knockimov/knocker_brewery_ispindle/pics/assembled.jpg

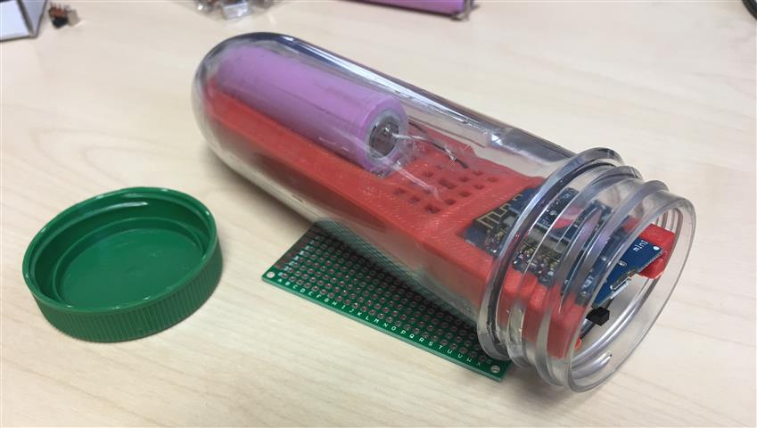
pics/assembled.jpg
