knockimov/knocker_brewery_ispindle/pics/assembled2.jpg

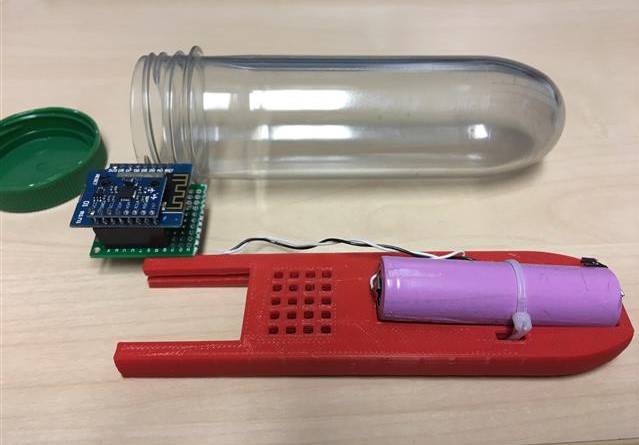
pics/assembled2.jpg
