knockimov/knocker_brewery_ispindle/drawer/mwx-Edition/mwx-Edition.jpg

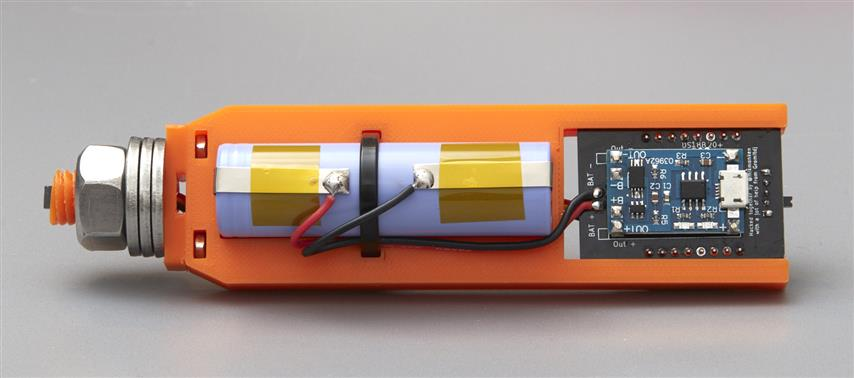
drawer/mwx-Edition/mwx-Edition.jpg
