knockimov/knocker_brewery_ispindle/images/esp8266_E12_pinouts.png

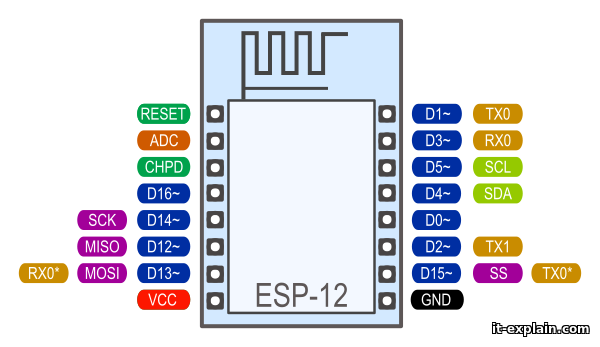
images/esp8266_E12_pinouts.png
