knockimov/knocker_brewery_ispindle/images/ispindel-v150-ESP12F--SMD1206_pcb.png

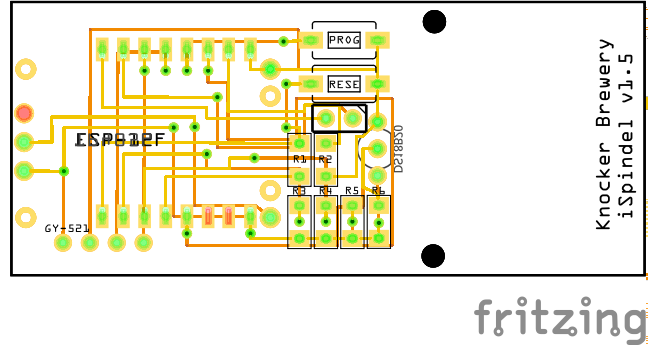
images/ispindel-v150-ESP12F--SMD1206_pcb.png
