knockimov/knocker_brewery_ispindle/images/ispindel-v150-WemosD1--SMD1206_pcb.png

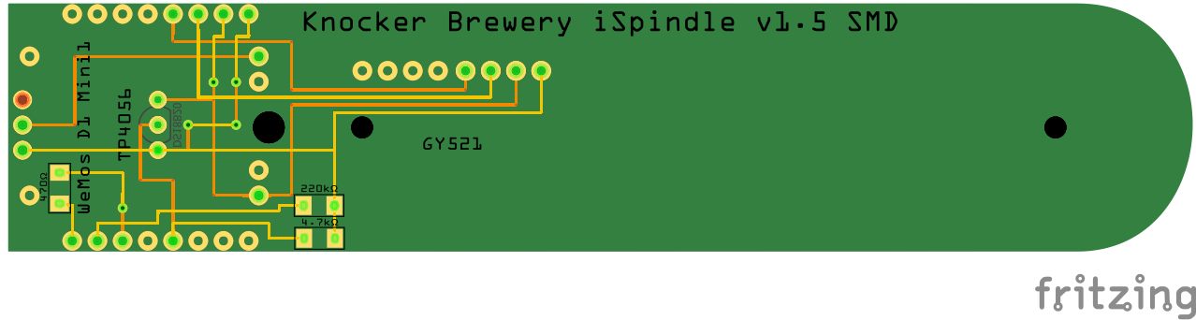
images/ispindel-v150-WemosD1--SMD1206_pcb.png
