knockimov/knocker_brewery_ispindle/pics/AP.png

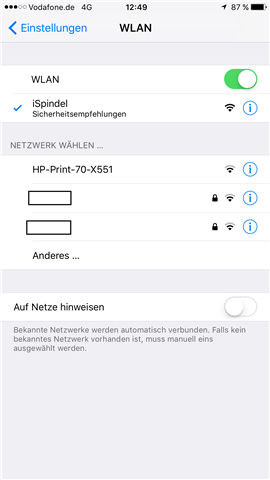
pics/AP.png
