knockimov/knocker_brewery_ispindle/pics/BB/1.jpg

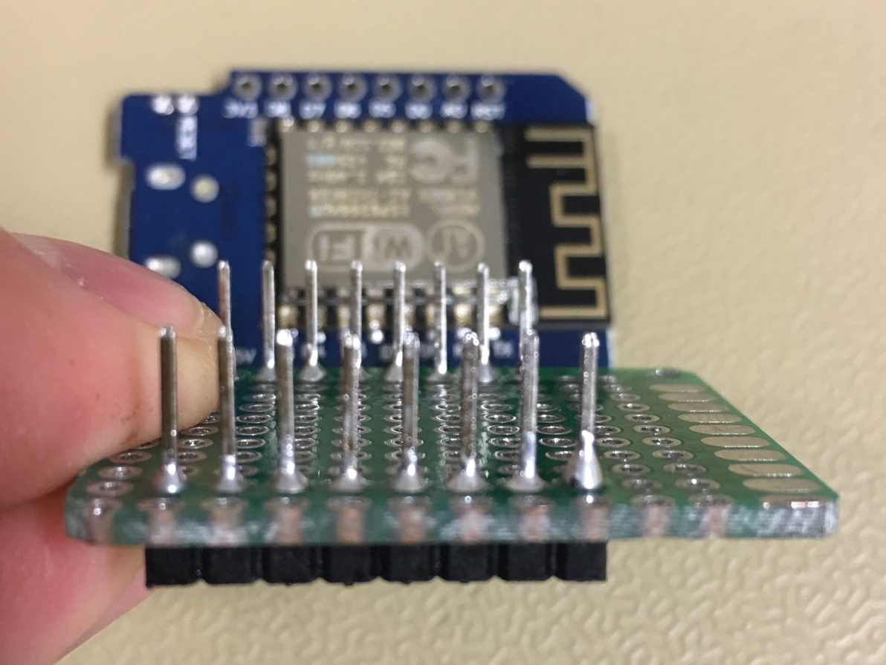
pics/BB/1.jpg
