knockimov/knocker_brewery_ispindle/pics/BB/2.jpg

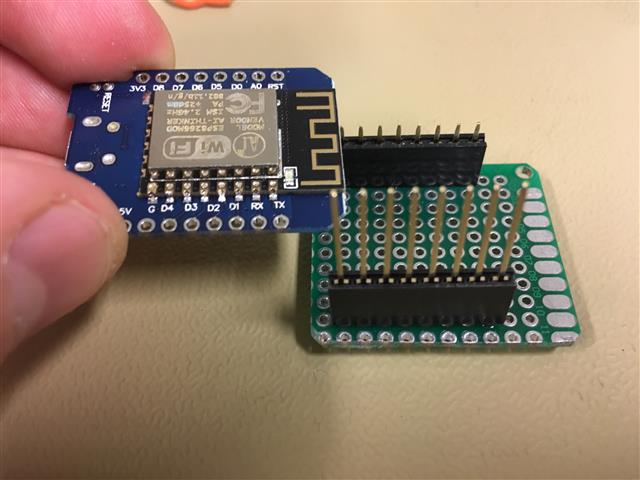
pics/BB/2.jpg
