knockimov/knocker_brewery_ispindle/pics/BB/3.jpg

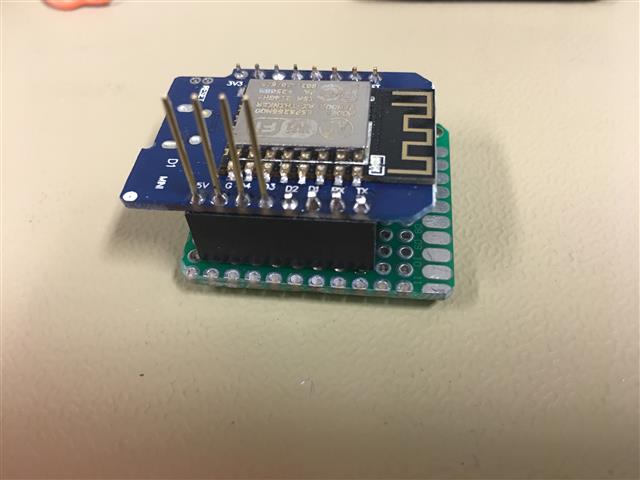
pics/BB/3.jpg
