knockimov/knocker_brewery_ispindle/pics/BB/4.jpg

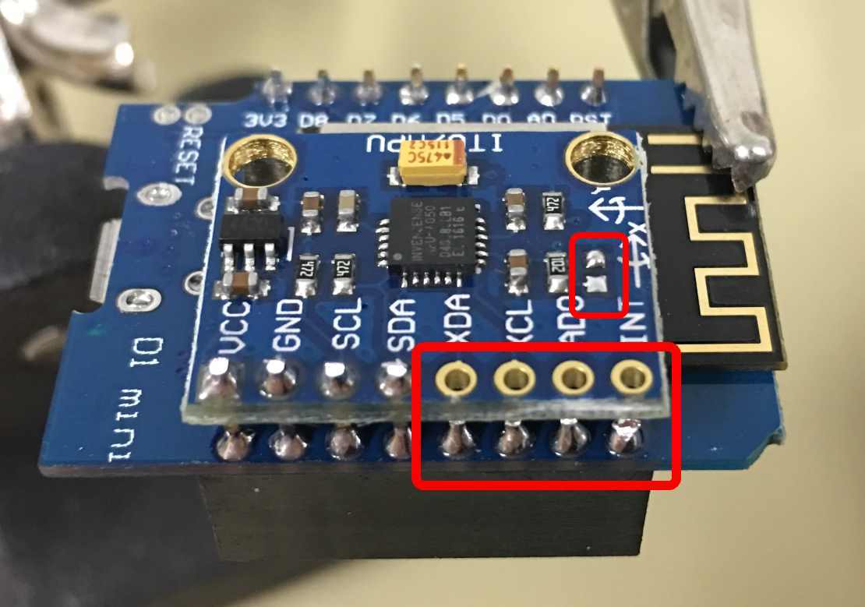
pics/BB/4.jpg
