knockimov/knocker_brewery_ispindle/pics/BB/5.jpg

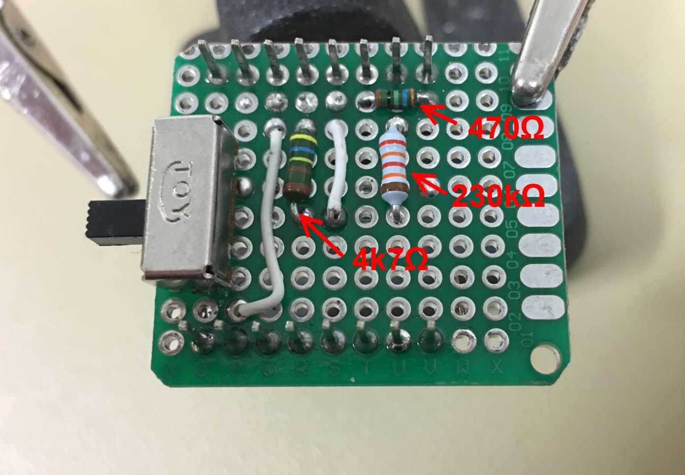
pics/BB/5.jpg
