knockimov/knocker_brewery_ispindle/pics/BB/6.jpg

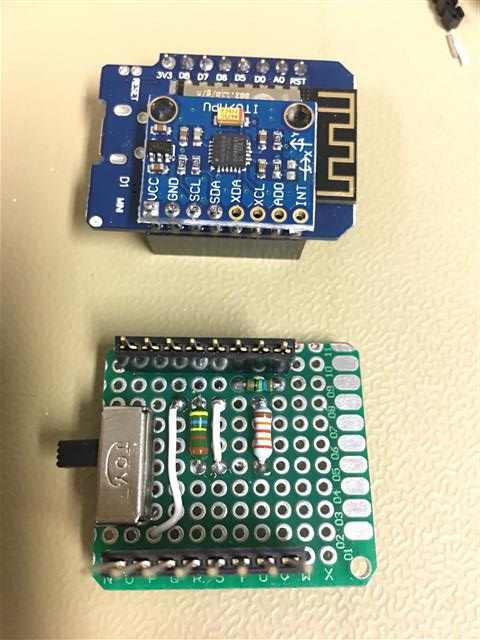
pics/BB/6.jpg
