knockimov/knocker_brewery_ispindle/pics/BB/7.jpg

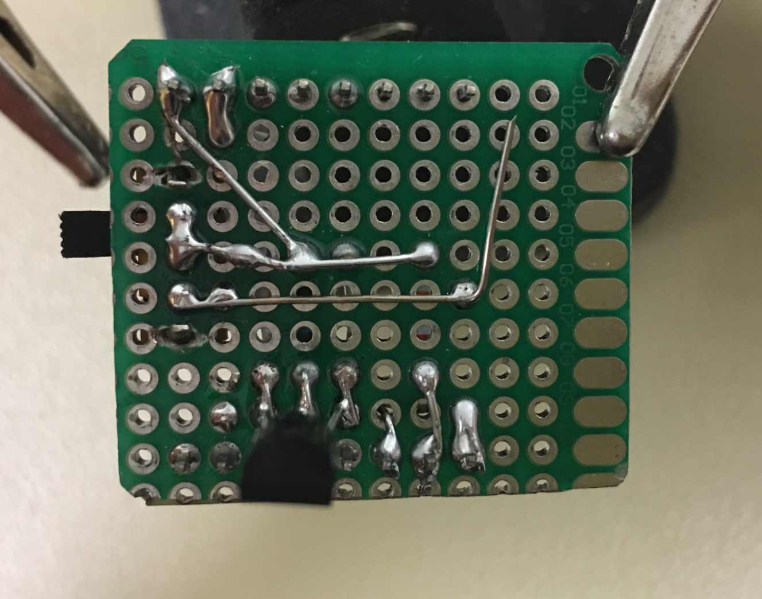
pics/BB/7.jpg
