knockimov/knocker_brewery_ispindle/pics/BB/8.jpg

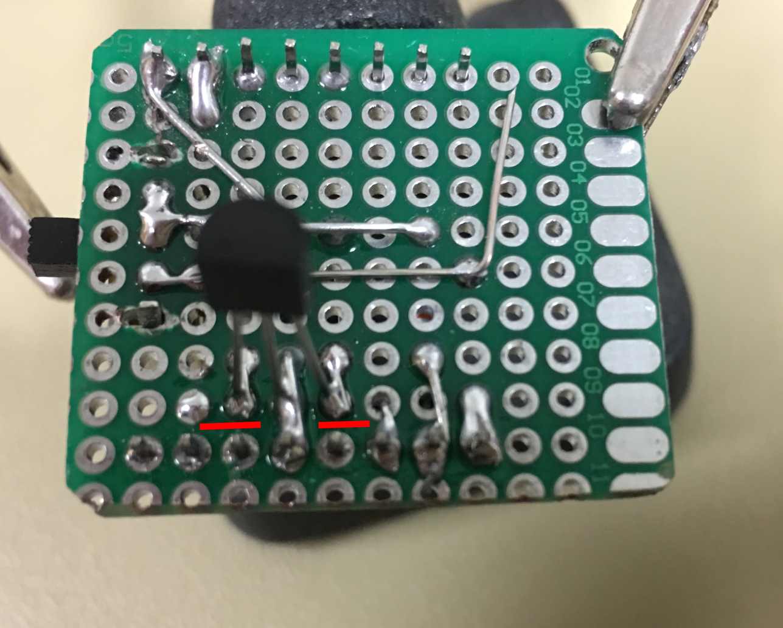
pics/BB/8.jpg
