knockimov/knocker_brewery_ispindle/pics/BB/9.jpg

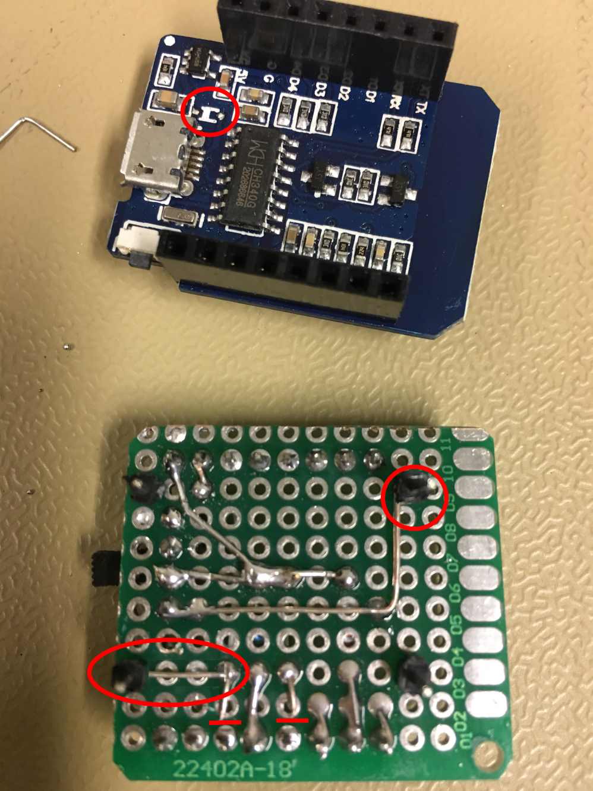
pics/BB/9.jpg
