knockimov/knocker_brewery_ispindle/pics/BB/10.jpg

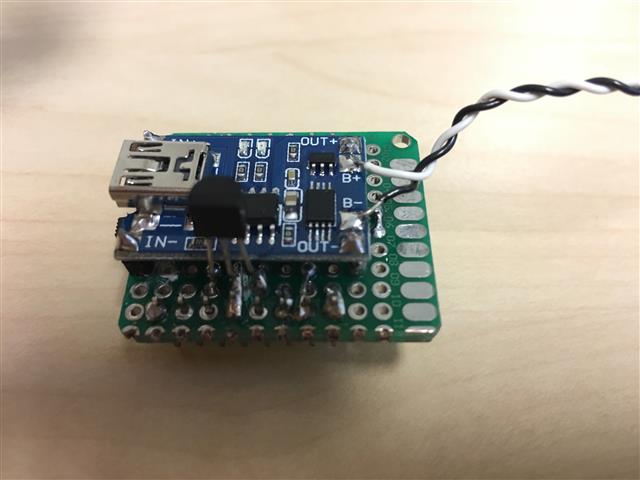
pics/BB/10.jpg
