knockimov/knocker_brewery_ispindle/pics/BB/11.jpg

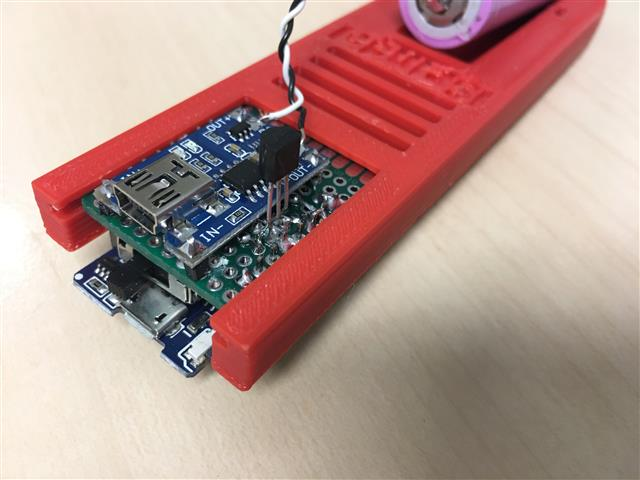
pics/BB/11.jpg
