knockimov/knocker_brewery_ispindle/pics/blackedition.png

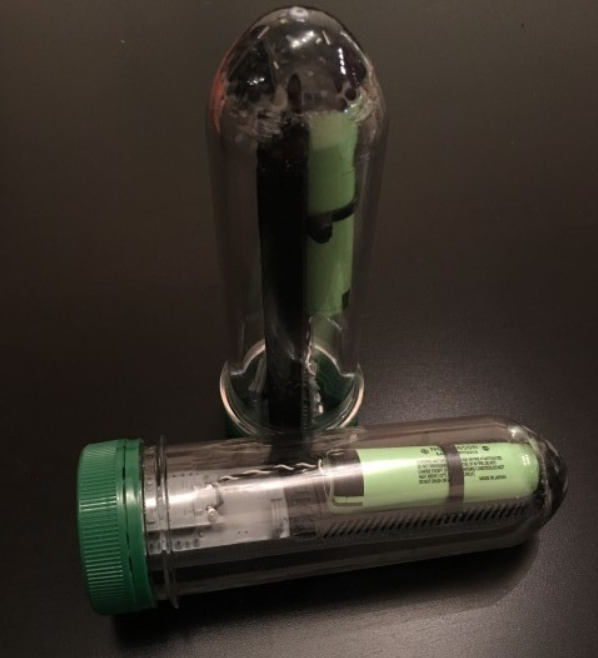
pics/blackedition.png
