knockimov/knocker_brewery_ispindle/pics/Braumagazin.png

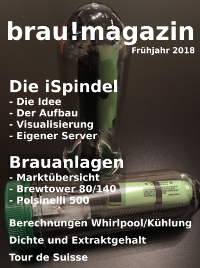
pics/Braumagazin.png
