knockimov/knocker_brewery_ispindle/pics/configuration.png

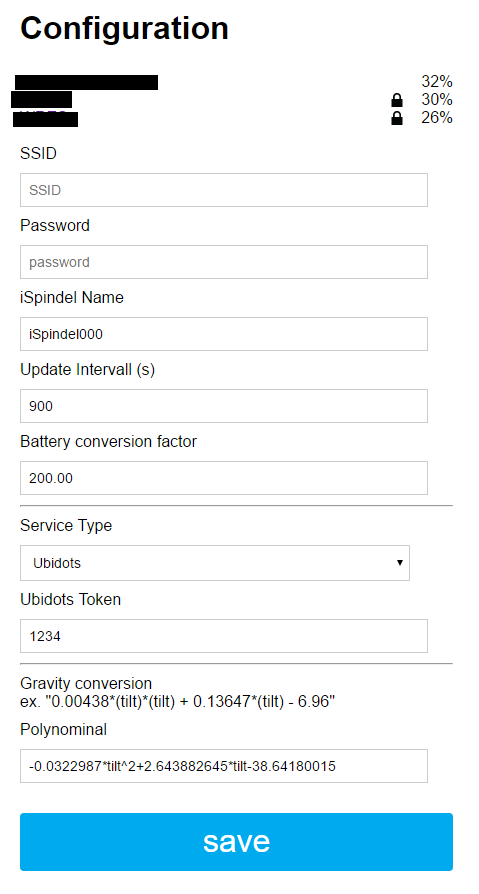
pics/configuration.png
