knockimov/knocker_brewery_ispindle/pics/Dashboard.jpg

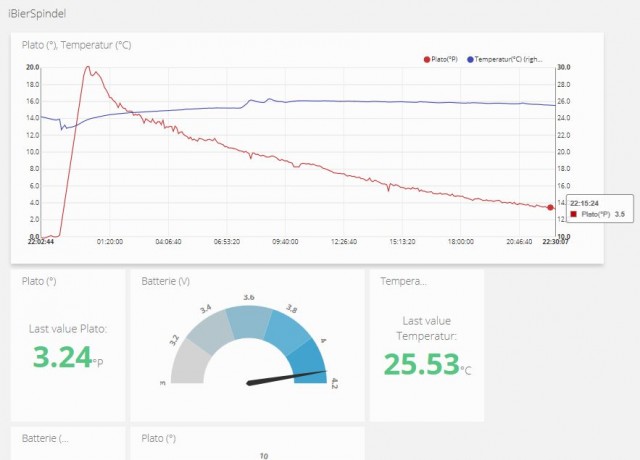
pics/Dashboard.jpg
