knockimov/knocker_brewery_ispindle/pics/Excelcalc.jpg

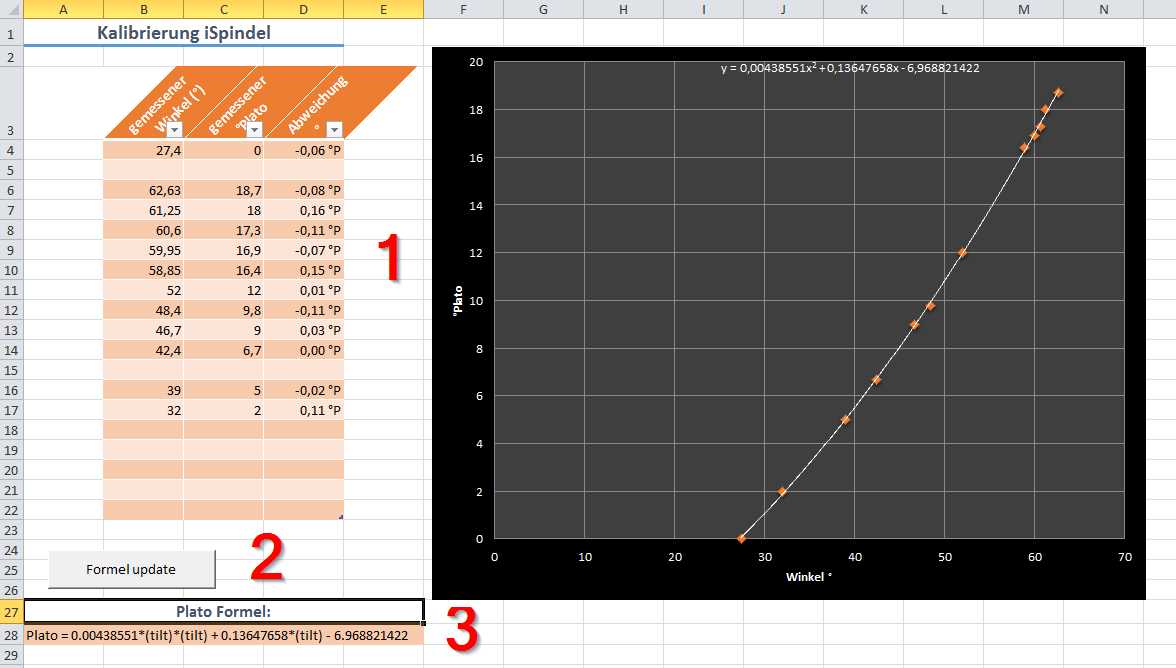
pics/Excelcalc.jpg
