knockimov/knocker_brewery_ispindle/pics/FHEM-iSpindel-gplot.png

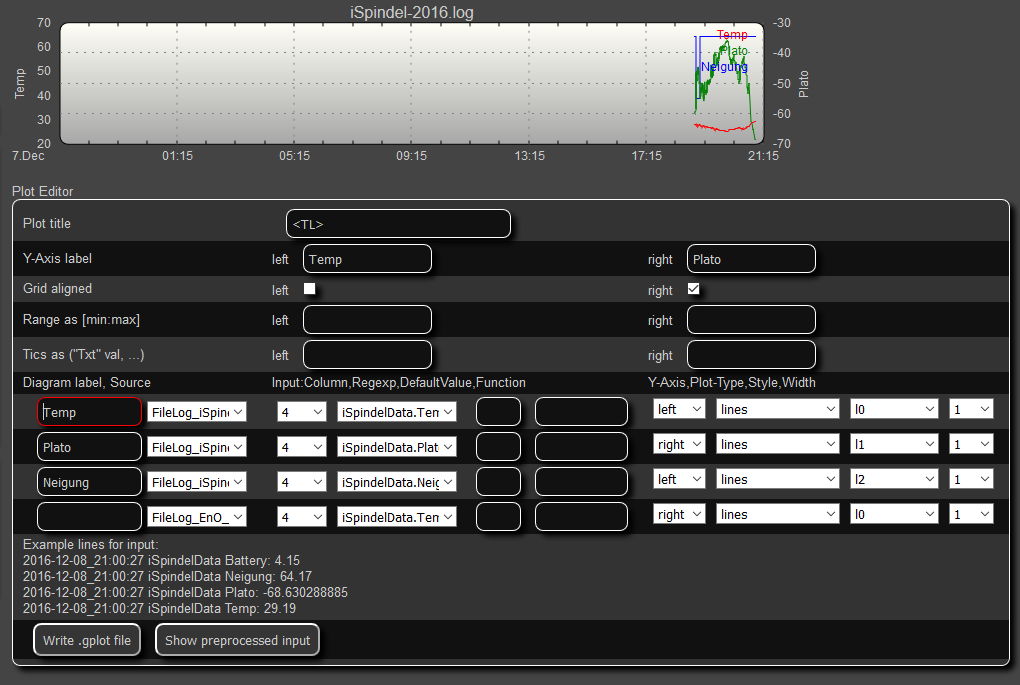
pics/FHEM-iSpindel-gplot.png
