knockimov/knocker_brewery_ispindle/pics/floating.jpg

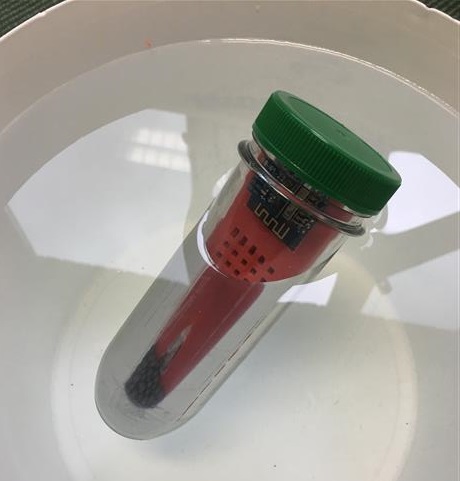
pics/floating.jpg
