knockimov/knocker_brewery_ispindle/pics/info.png

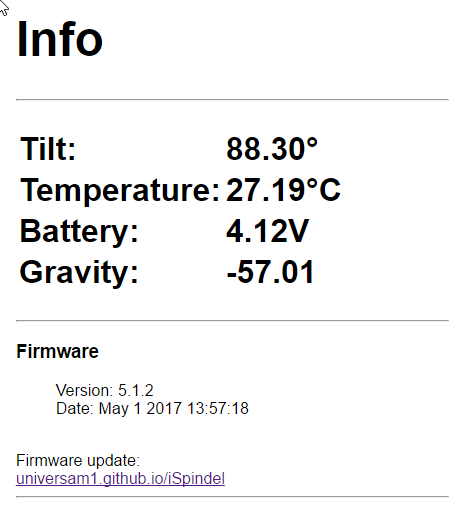
pics/info.png
