knockimov/knocker_brewery_ispindle/pics/kraengung.jpg

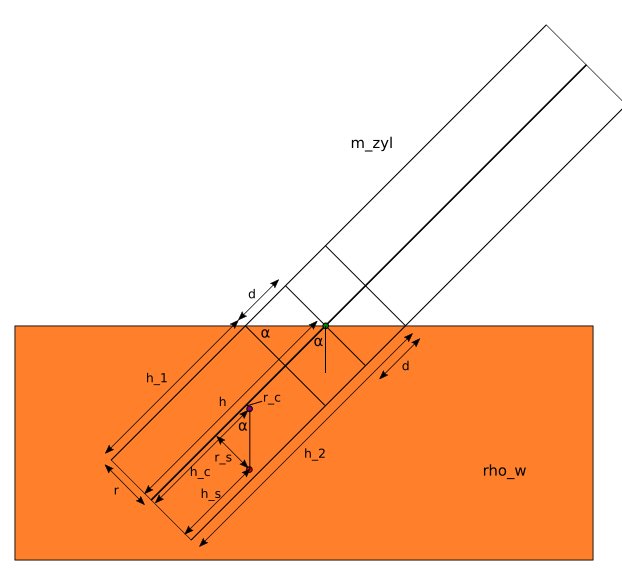
pics/kraengung.jpg
