knockimov/knocker_brewery_ispindle/pics/PCB+Tray/Diode.png

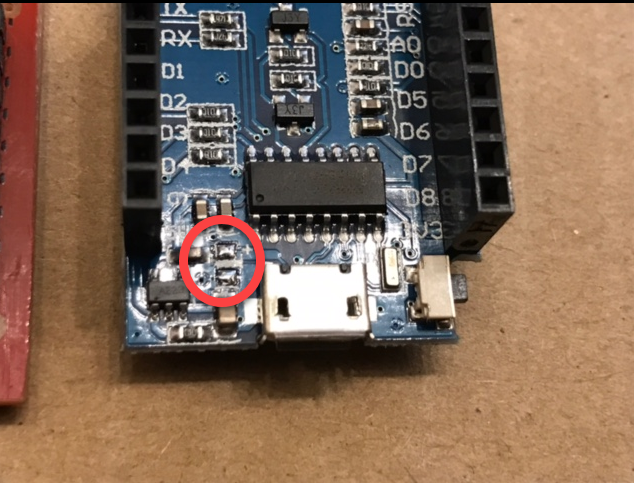
pics/PCB+Tray/Diode.png
