knockimov/knocker_brewery_ispindle/pics/PCB+Tray/IMG_9255.JPG

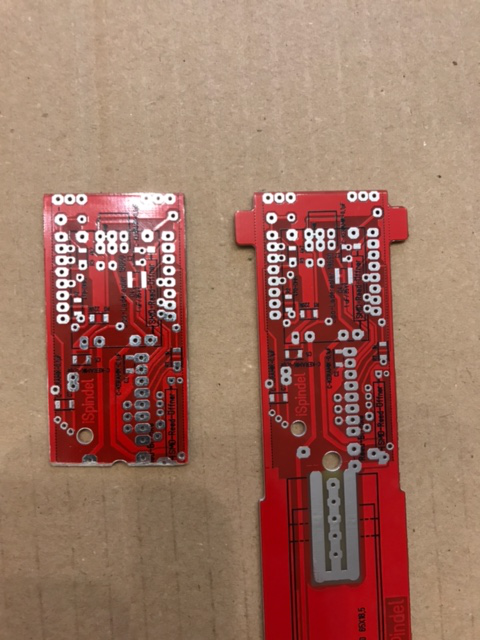
pics/PCB+Tray/IMG_9255.JPG
