knockimov/knocker_brewery_ispindle/pics/PCB+Tray/IMG_9256.JPG

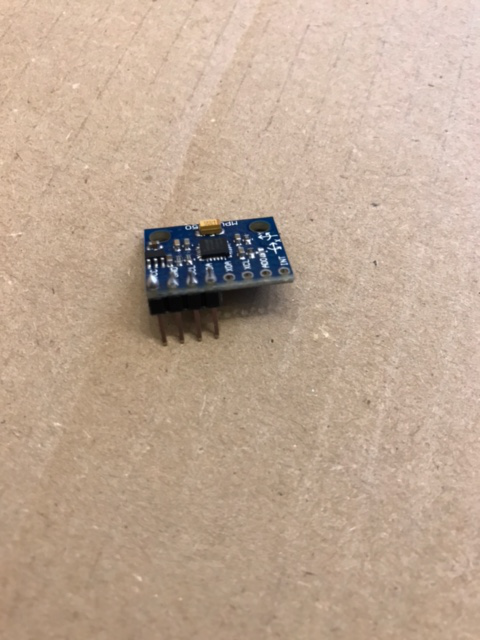
pics/PCB+Tray/IMG_9256.JPG
