knockimov/knocker_brewery_ispindle/pics/PCB+Tray/IMG_9259.JPG

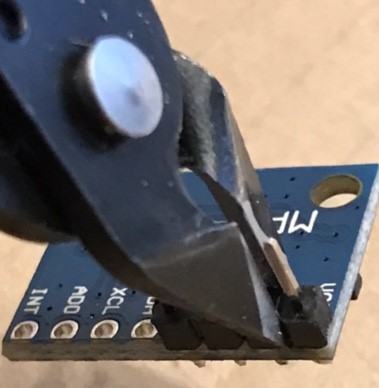
pics/PCB+Tray/IMG_9259.JPG
