knockimov/knocker_brewery_ispindle/pics/PCB+Tray/IMG_9260.JPG

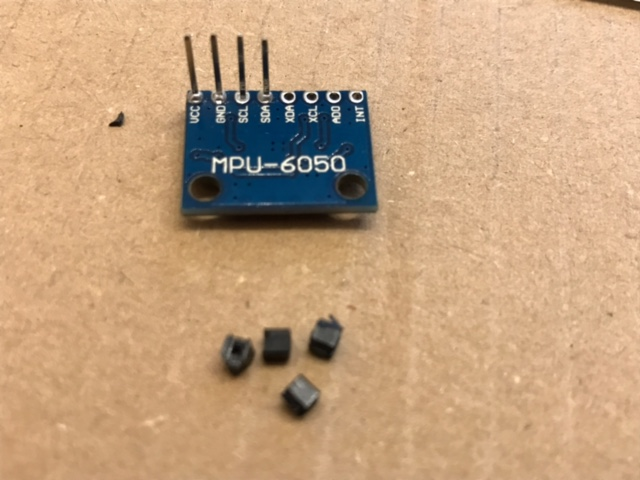
pics/PCB+Tray/IMG_9260.JPG
