knockimov/knocker_brewery_ispindle/pics/PCB+Tray/IMG_9262.JPG

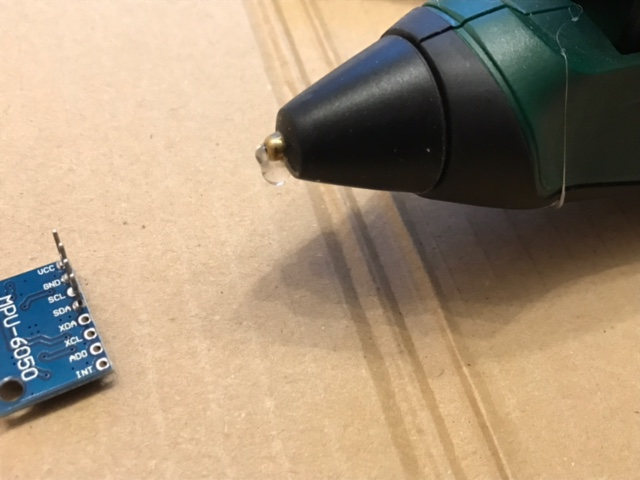
pics/PCB+Tray/IMG_9262.JPG
