knockimov/knocker_brewery_ispindle/pics/PCB+Tray/IMG_9263.JPG

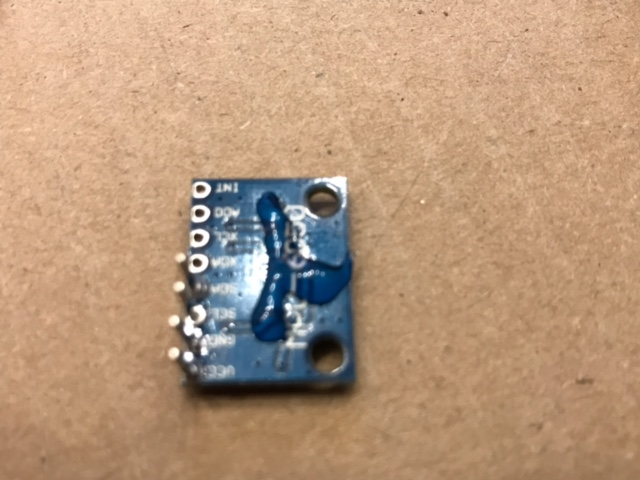
pics/PCB+Tray/IMG_9263.JPG
