knockimov/knocker_brewery_ispindle/pics/PCB+Tray/IMG_9264.JPG

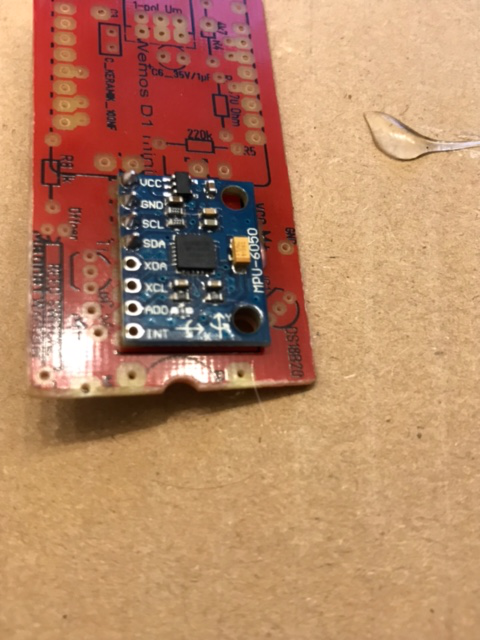
pics/PCB+Tray/IMG_9264.JPG
