knockimov/knocker_brewery_ispindle/pics/PCB+Tray/IMG_9265.JPG

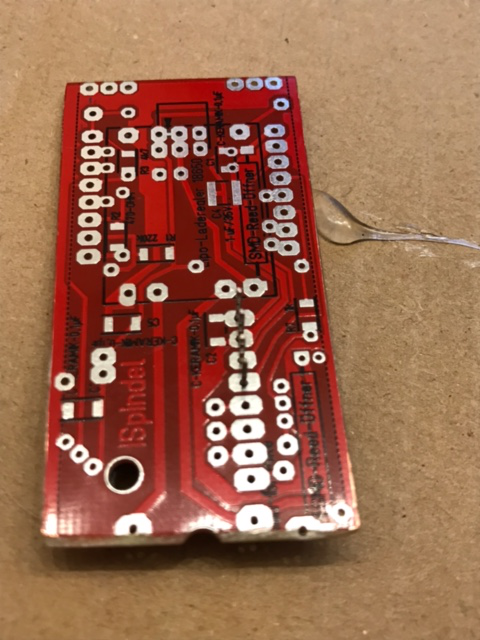
pics/PCB+Tray/IMG_9265.JPG
