knockimov/knocker_brewery_ispindle/pics/PCB+Tray/IMG_9266.JPG

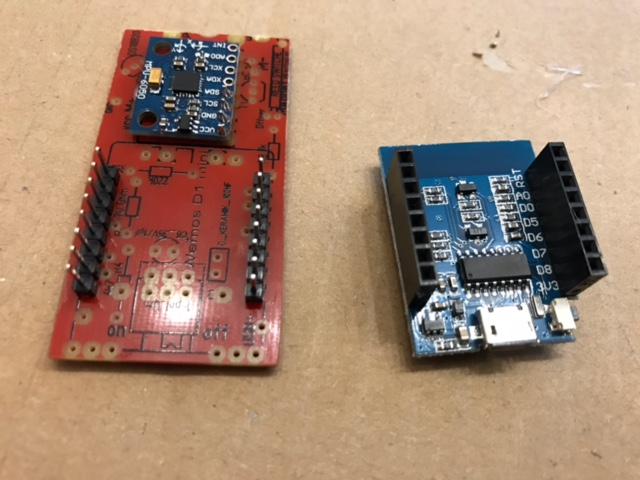
pics/PCB+Tray/IMG_9266.JPG
