knockimov/knocker_brewery_ispindle/pics/PCB+Tray/IMG_9272.JPG

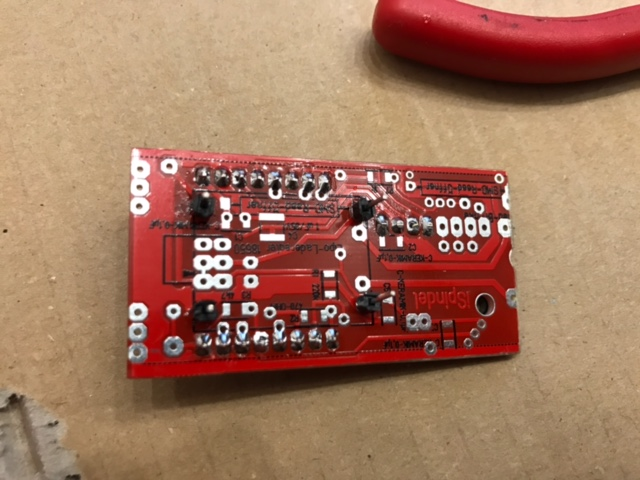
pics/PCB+Tray/IMG_9272.JPG
