knockimov/knocker_brewery_ispindle/pics/PCB+Tray/IMG_9273.JPG

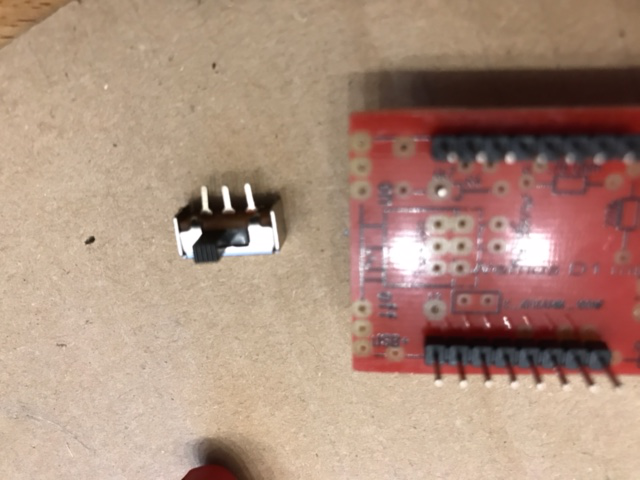
pics/PCB+Tray/IMG_9273.JPG
