knockimov/knocker_brewery_ispindle/pics/PCB+Tray/IMG_9279.JPG

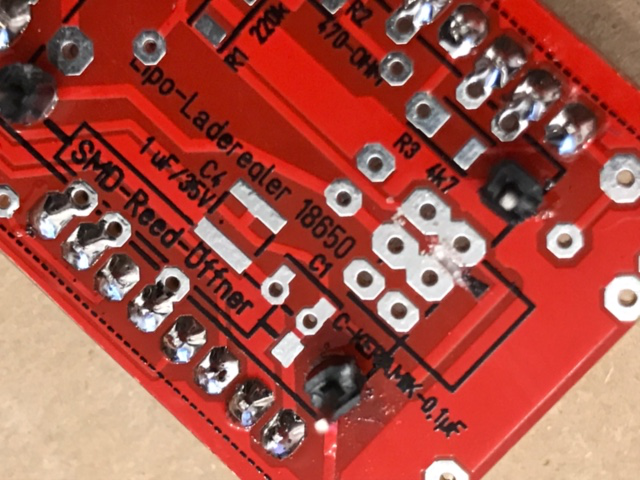
pics/PCB+Tray/IMG_9279.JPG
