knockimov/knocker_brewery_ispindle/pics/PCB+Tray/IMG_9281.JPG

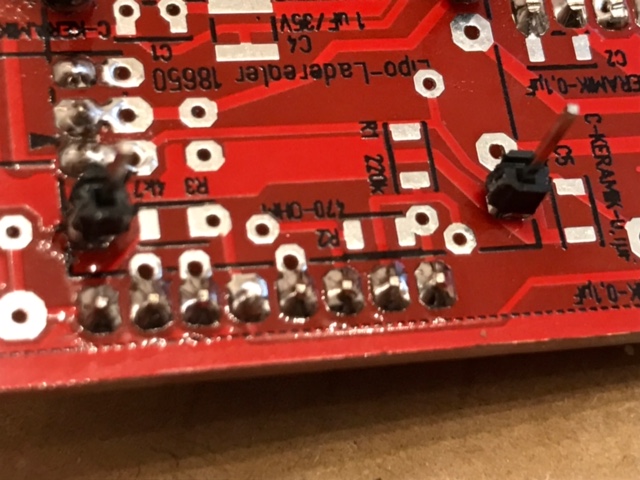
pics/PCB+Tray/IMG_9281.JPG
