knockimov/knocker_brewery_ispindle/pics/PCB+Tray/IMG_9282.JPG

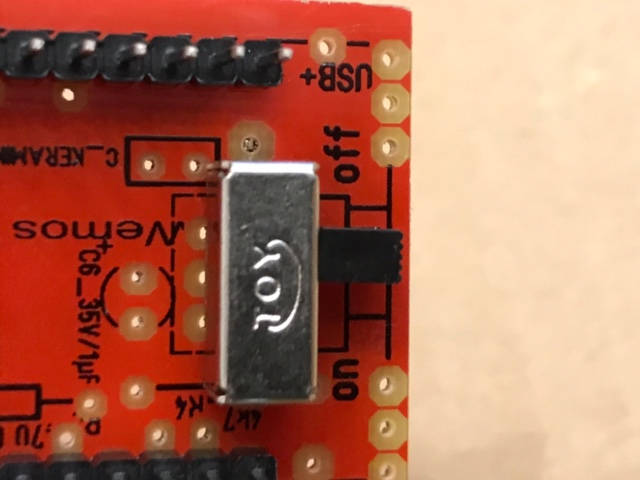
pics/PCB+Tray/IMG_9282.JPG
