knockimov/knocker_brewery_ispindle/pics/PCB+Tray/IMG_9283.JPG

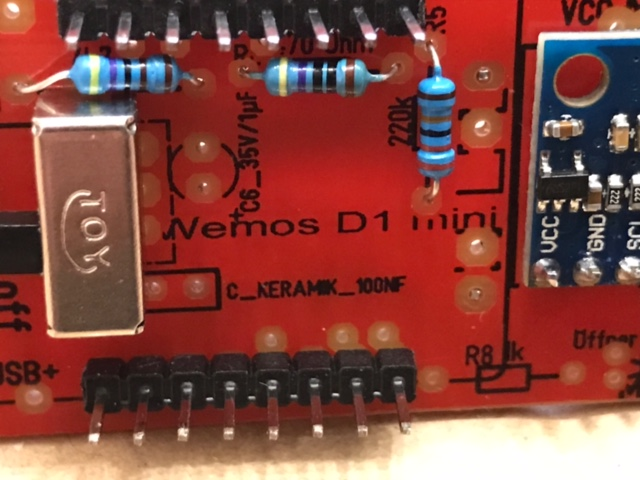
pics/PCB+Tray/IMG_9283.JPG
