knockimov/knocker_brewery_ispindle/pics/PCB+Tray/IMG_9284.JPG

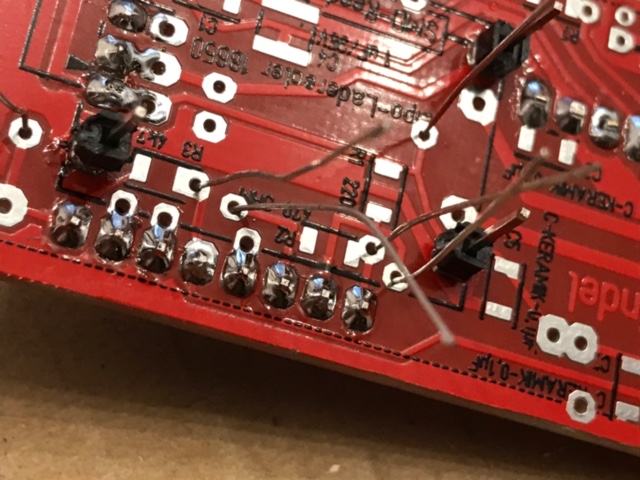
pics/PCB+Tray/IMG_9284.JPG
