knockimov/knocker_brewery_ispindle/pics/PCB+Tray/IMG_9288.JPG

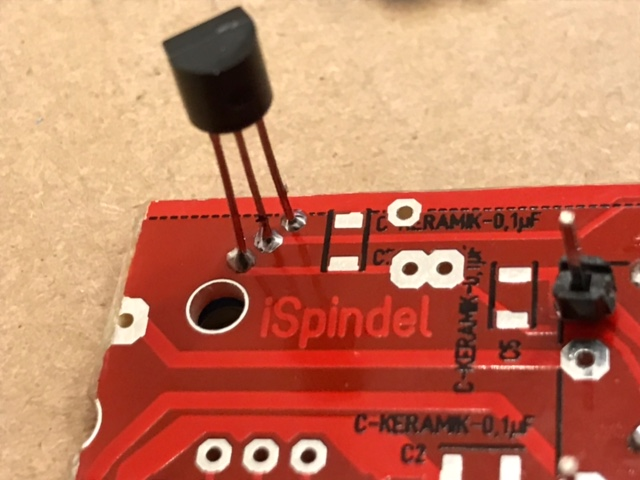
pics/PCB+Tray/IMG_9288.JPG
