knockimov/knocker_brewery_ispindle/pics/PCB+Tray/IMG_9290.JPG

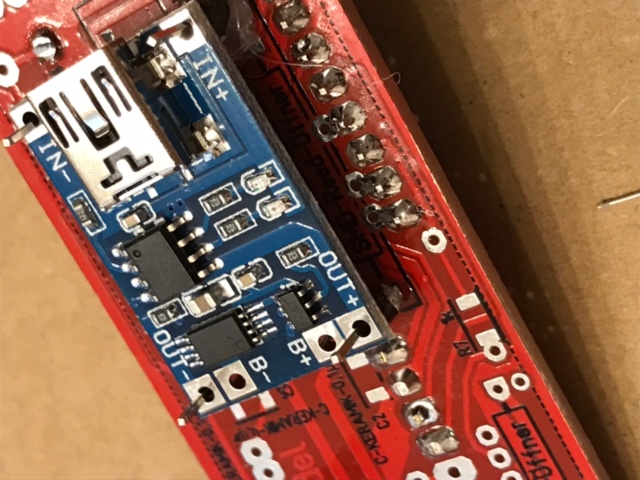
pics/PCB+Tray/IMG_9290.JPG
