knockimov/knocker_brewery_ispindle/pics/PCB+Tray/IMG_9291.JPG

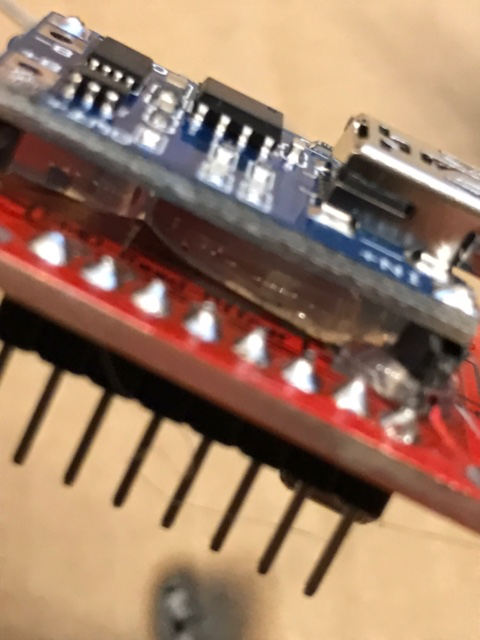
pics/PCB+Tray/IMG_9291.JPG
