knockimov/knocker_brewery_ispindle/pics/PCB+Tray/IMG_9292.JPG

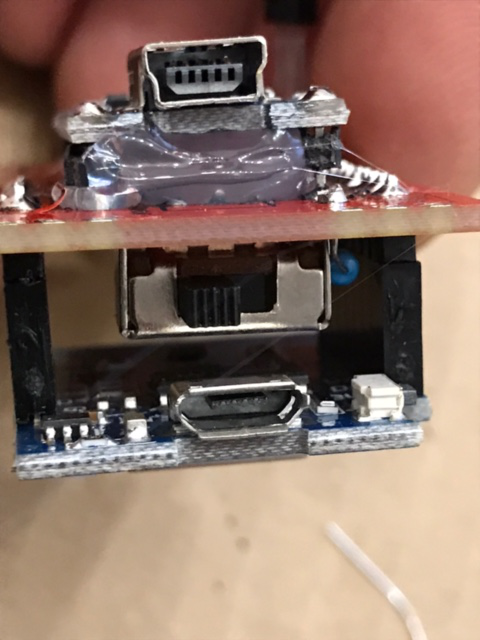
pics/PCB+Tray/IMG_9292.JPG
