knockimov/knocker_brewery_ispindle/pics/PCB+Tray/IMG_9293.JPG

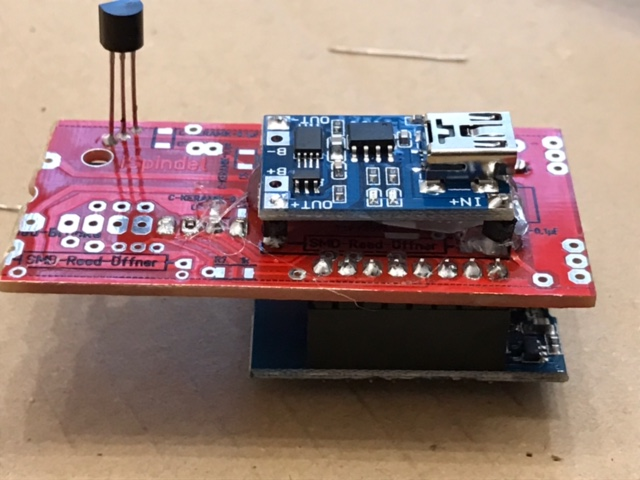
pics/PCB+Tray/IMG_9293.JPG
