knockimov/knocker_brewery_ispindle/pics/PCB+Tray/IMG_9294.JPG

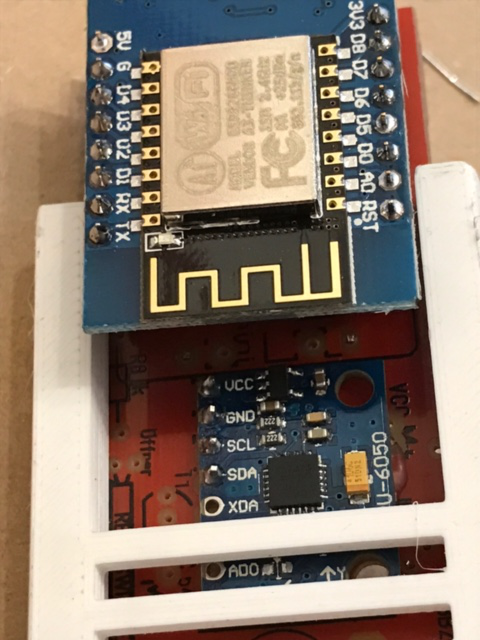
pics/PCB+Tray/IMG_9294.JPG
