knockimov/knocker_brewery_ispindle/pics/PCB+Tray/IMG_9296.JPG

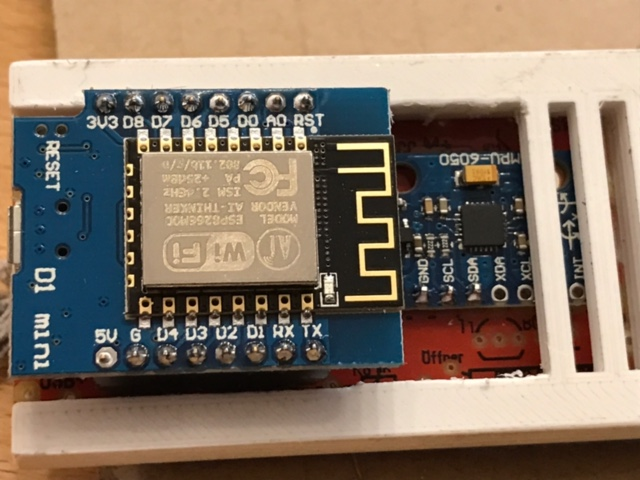
pics/PCB+Tray/IMG_9296.JPG
