knockimov/knocker_brewery_ispindle/pics/PCB+Tray/IMG_9297.JPG

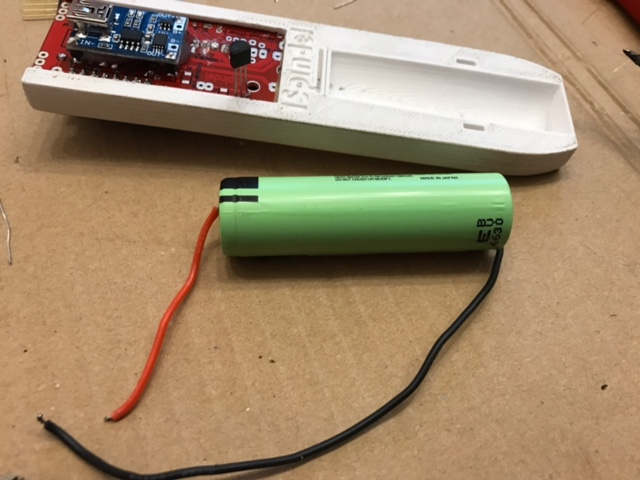
pics/PCB+Tray/IMG_9297.JPG
