knockimov/knocker_brewery_ispindle/pics/PCB+Tray/IMG_9298.JPG

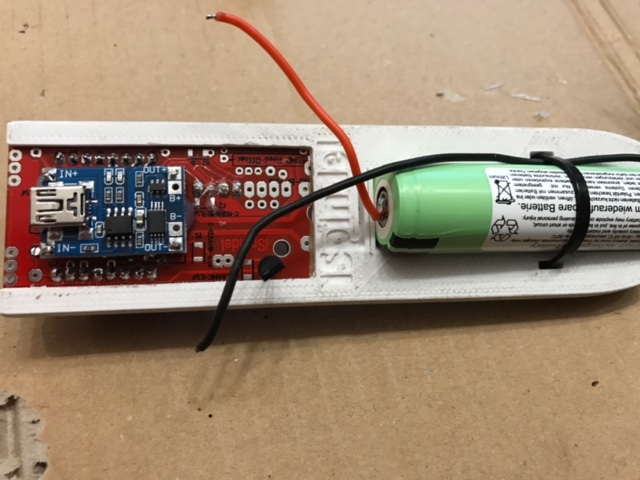
pics/PCB+Tray/IMG_9298.JPG
