knockimov/knocker_brewery_ispindle/pics/PCB+Tray/IMG_9299.JPG

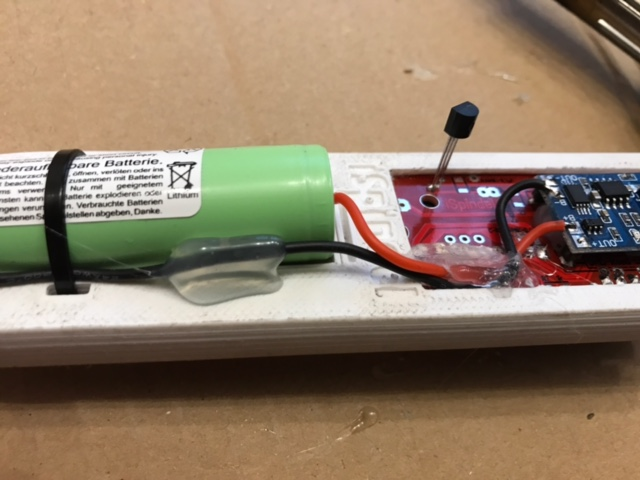
pics/PCB+Tray/IMG_9299.JPG
