knockimov/knocker_brewery_ispindle/pics/PCB+Tray/IMG_9300.JPG

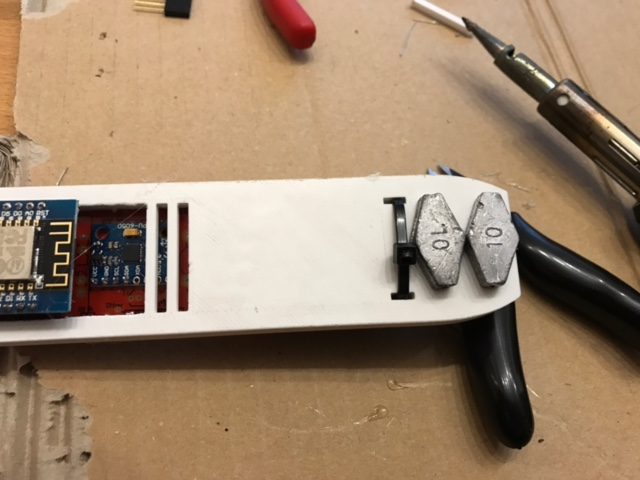
pics/PCB+Tray/IMG_9300.JPG
