knockimov/knocker_brewery_ispindle/pics/PCB+Tray/IMG_9301.JPG

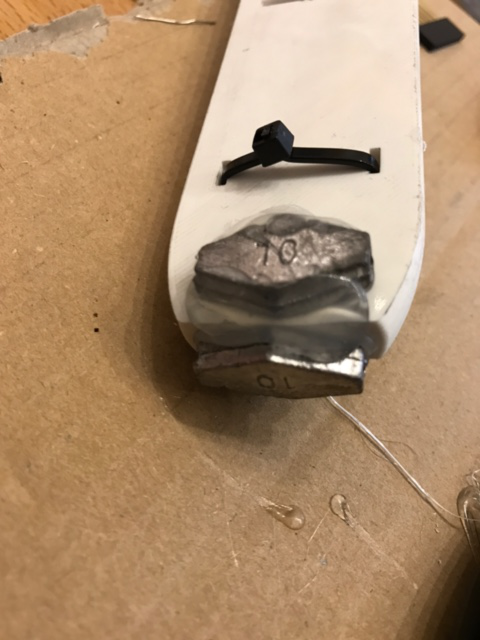
pics/PCB+Tray/IMG_9301.JPG
