knockimov/knocker_brewery_ispindle/pics/PCB+Tray/IMG_9303.JPG

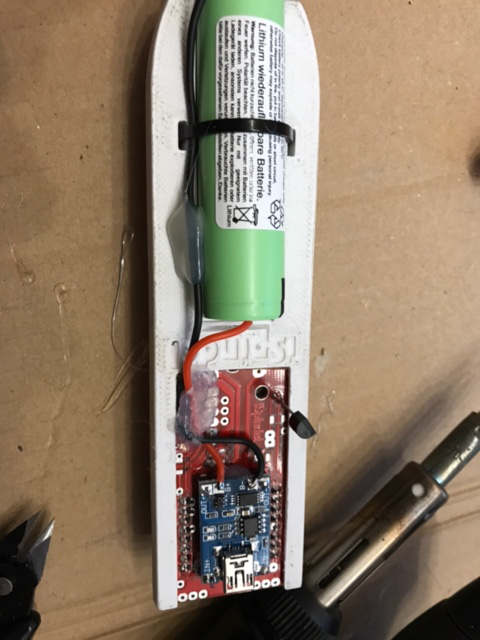
pics/PCB+Tray/IMG_9303.JPG
