knockimov/knocker_brewery_ispindle/pics/PCB+Tray/IMG_9304.JPG

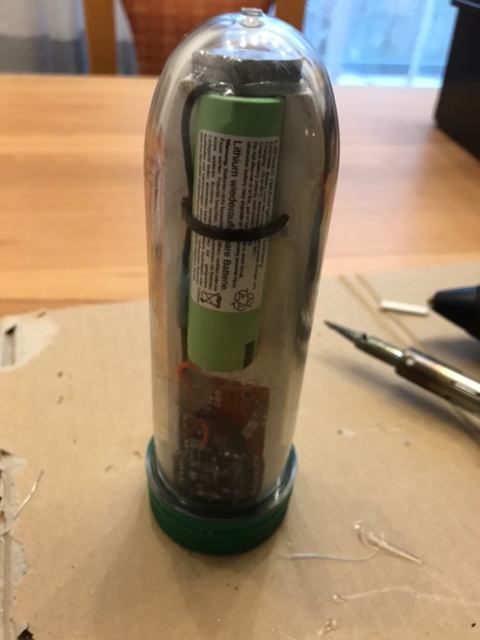
pics/PCB+Tray/IMG_9304.JPG
