knockimov/knocker_brewery_ispindle/pics/PCB+Tray/LED.png

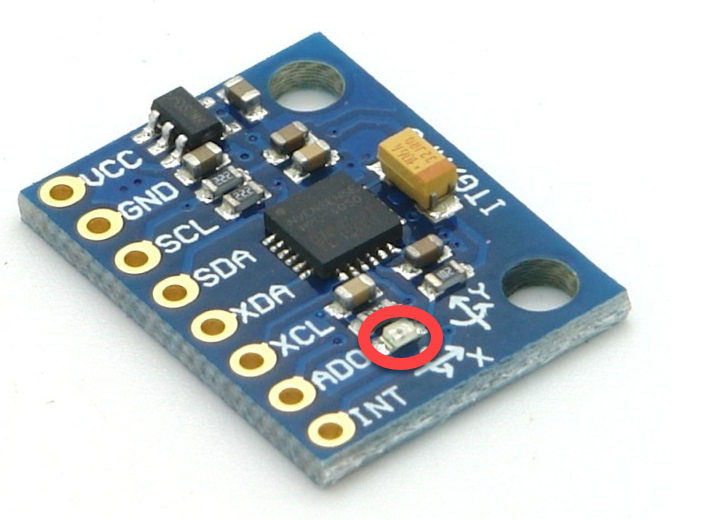
pics/PCB+Tray/LED.png
