knockimov/knocker_brewery_ispindle/pics/PCB/01-Schalterbruecke.JPG

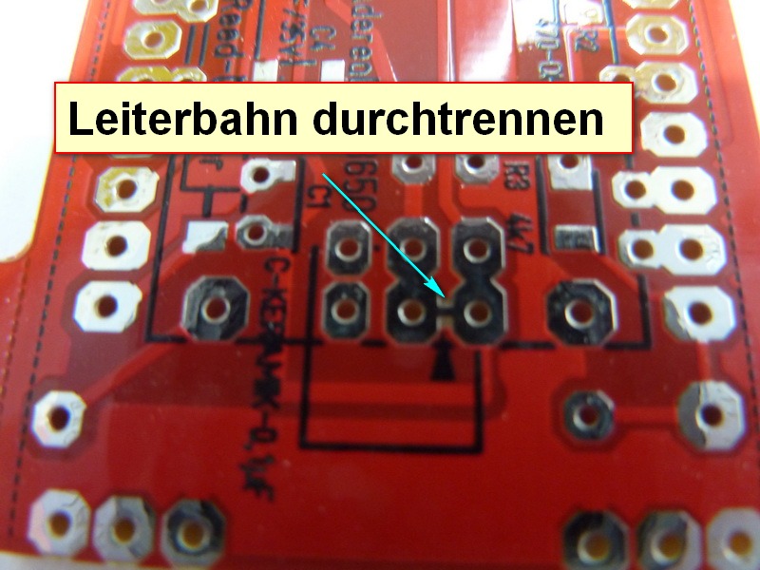
pics/PCB/01-Schalterbruecke.JPG
