knockimov/knocker_brewery_ispindle/pics/PCB/02-durchtrennt.JPG

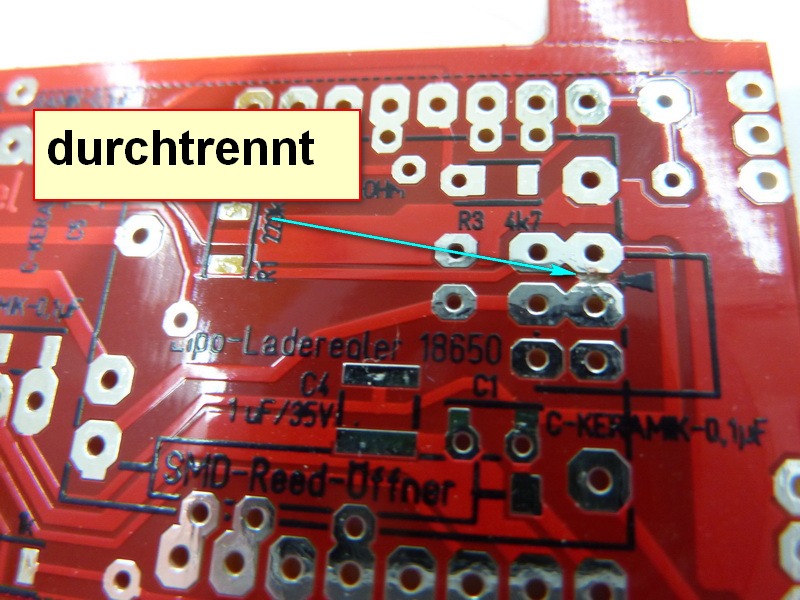
pics/PCB/02-durchtrennt.JPG
