knockimov/knocker_brewery_ispindle/pics/PCB/03-Schaltervarianten.JPG

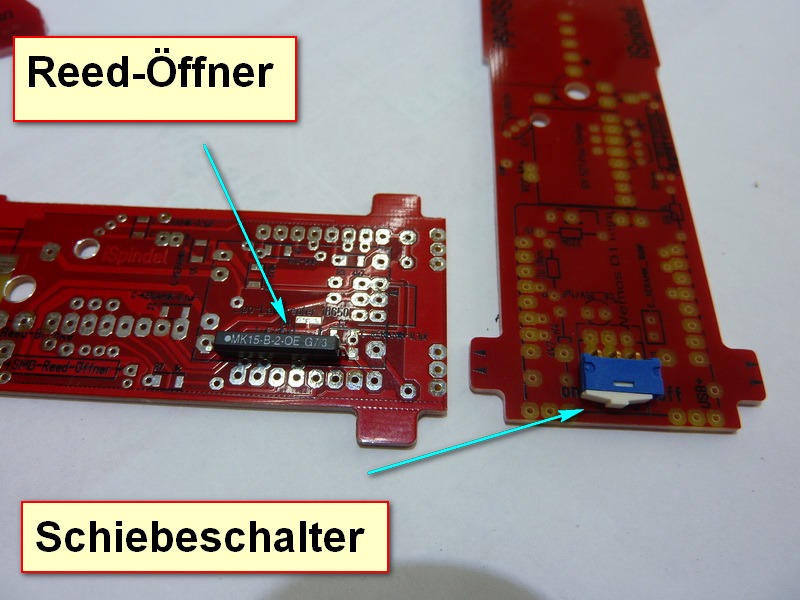
pics/PCB/03-Schaltervarianten.JPG
