knockimov/knocker_brewery_ispindle/pics/PCB/04-SMDReed-Oeffner.JPG

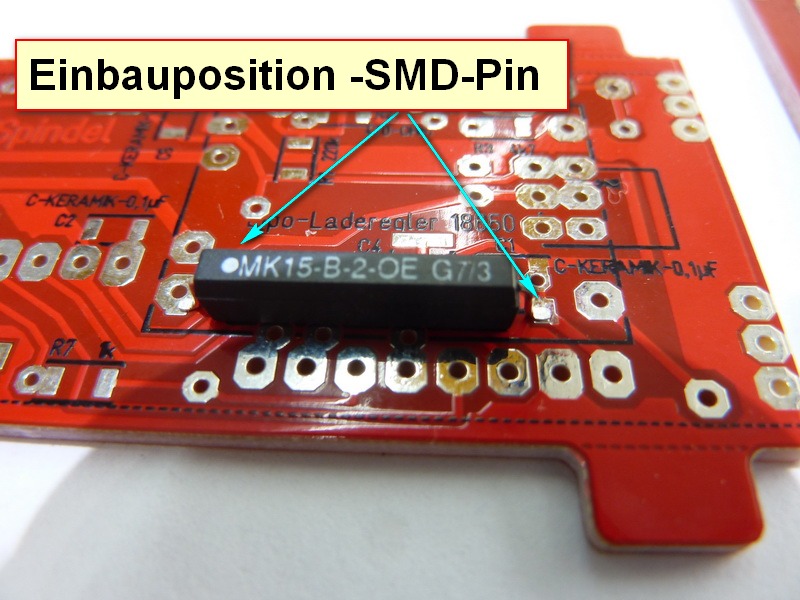
pics/PCB/04-SMDReed-Oeffner.JPG
