knockimov/knocker_brewery_ispindle/pics/PCB/05-Schiebeschalter.JPG

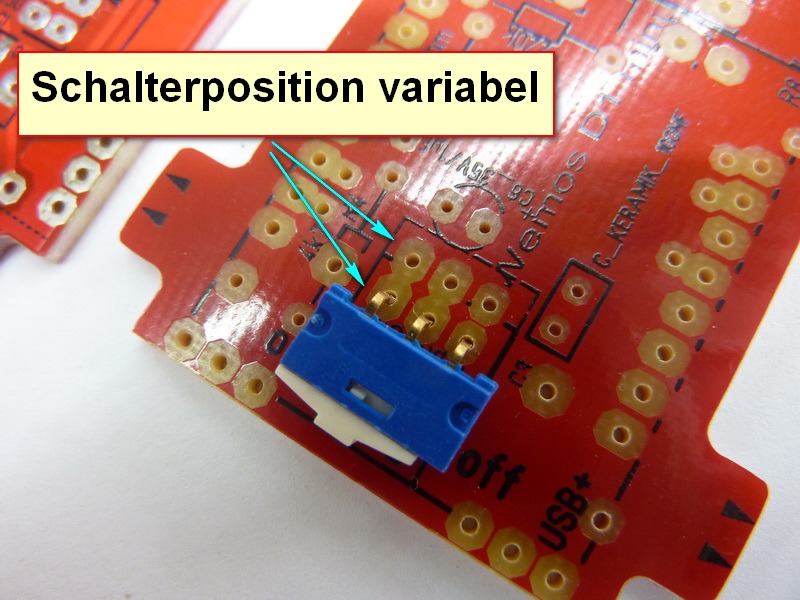
pics/PCB/05-Schiebeschalter.JPG
