knockimov/knocker_brewery_ispindle/pics/PCB/06-Jumper.JPG

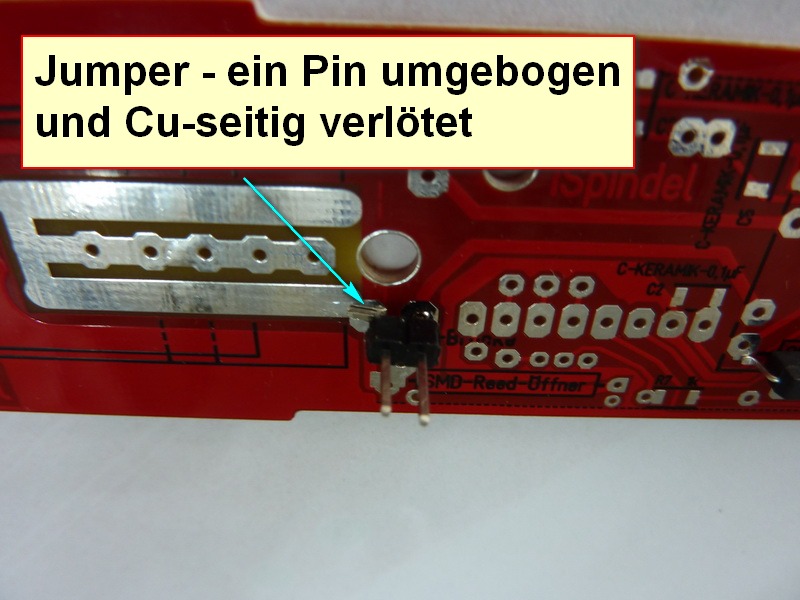
pics/PCB/06-Jumper.JPG
