knockimov/knocker_brewery_ispindle/pics/PCB/07-Jumper.JPG

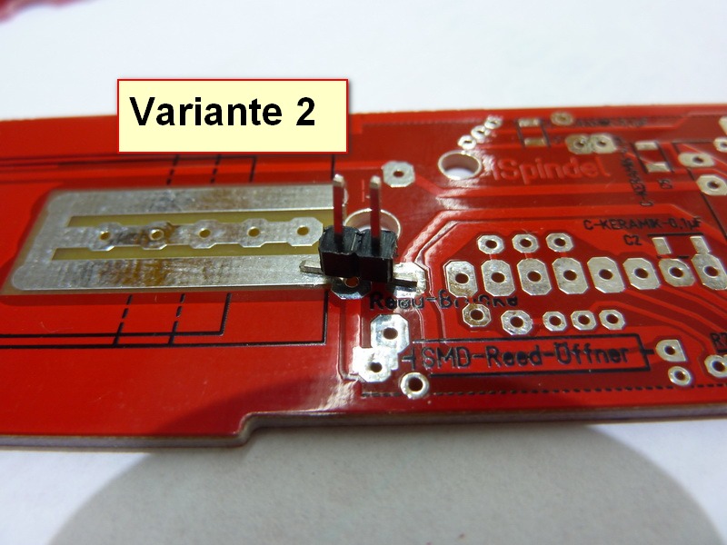
pics/PCB/07-Jumper.JPG
