knockimov/knocker_brewery_ispindle/pics/PCB/08-Jumper.JPG

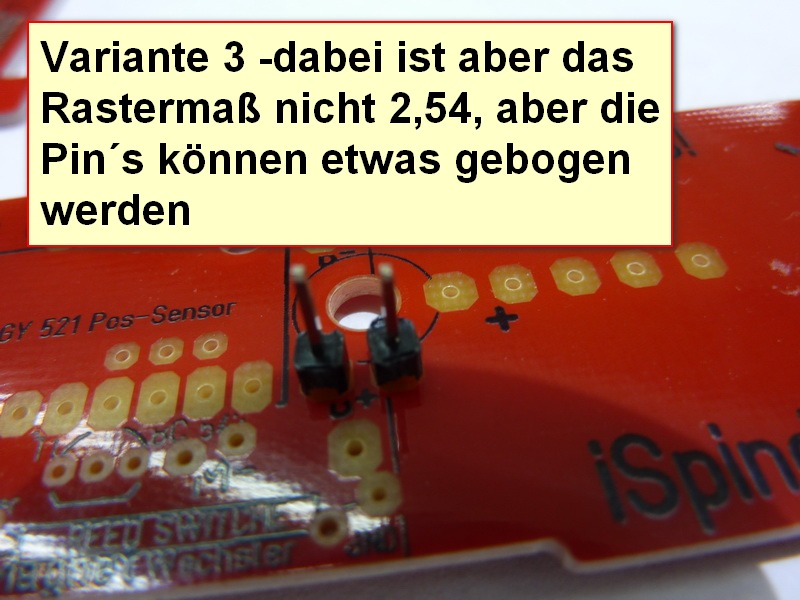
pics/PCB/08-Jumper.JPG
