knockimov/knocker_brewery_ispindle/pics/PCB/09-Jumper.JPG

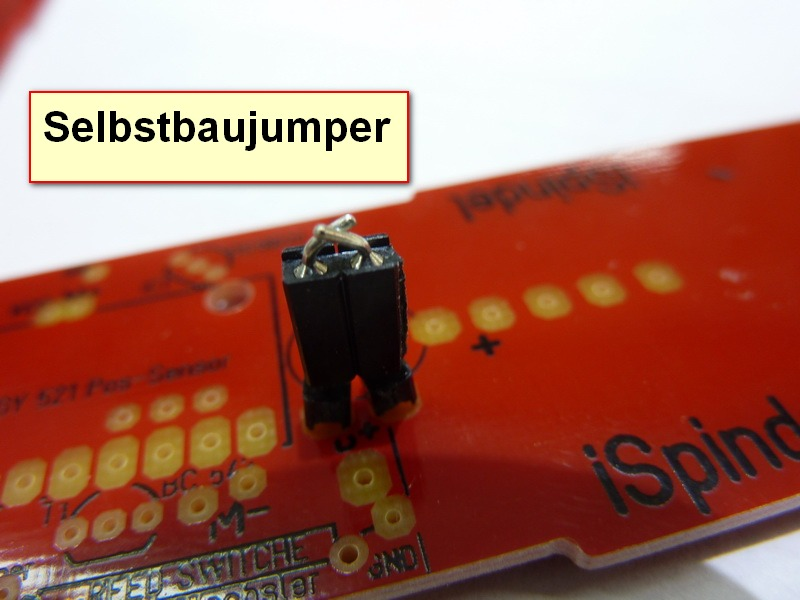
pics/PCB/09-Jumper.JPG
