knockimov/knocker_brewery_ispindle/pics/PCB/10-Widerstaende.JPG

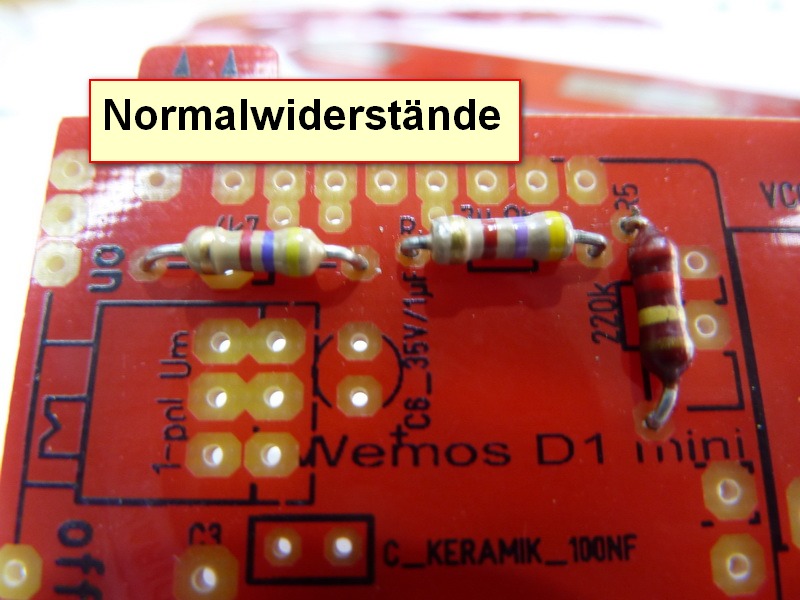
pics/PCB/10-Widerstaende.JPG
