knockimov/knocker_brewery_ispindle/pics/PCB/11-SMD-Widerstaende.JPG

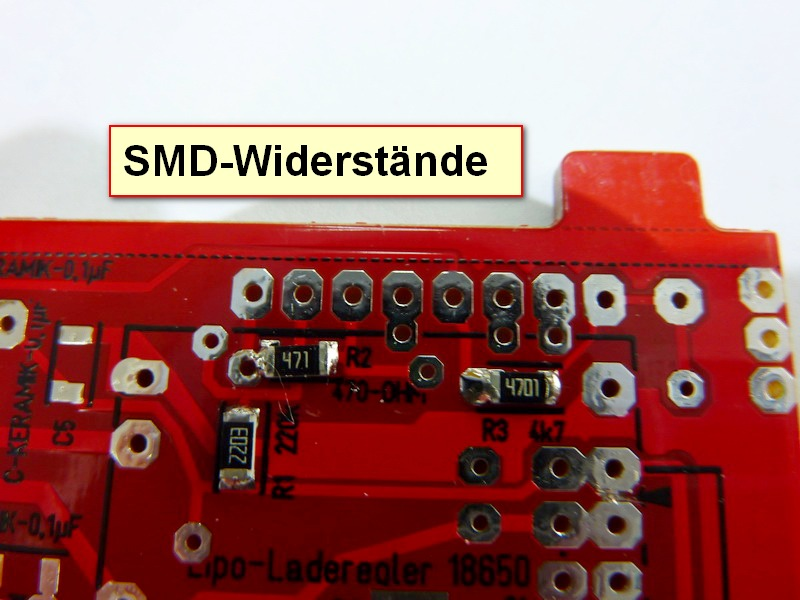
pics/PCB/11-SMD-Widerstaende.JPG
