knockimov/knocker_brewery_ispindle/pics/PCB/12-GY521Vorbereitung.JPG

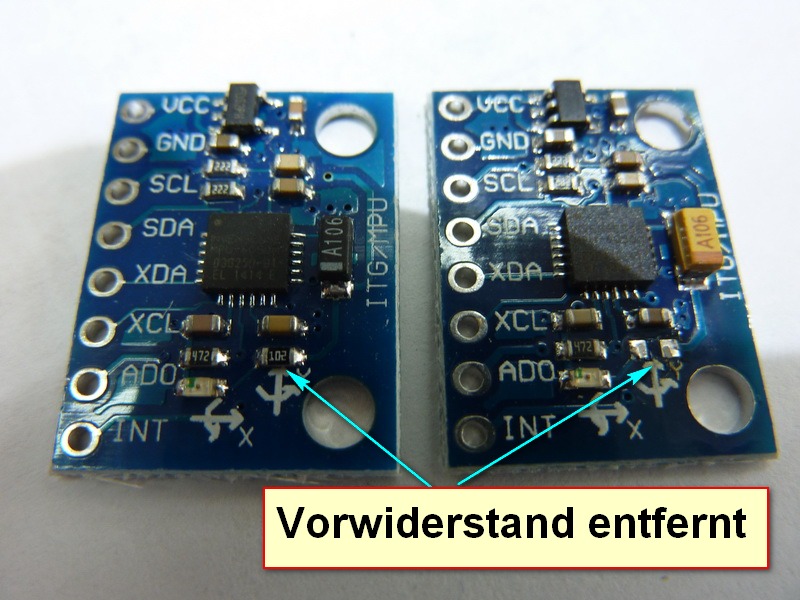
pics/PCB/12-GY521Vorbereitung.JPG
