knockimov/knocker_brewery_ispindle/pics/PCB/12-LED-beim-GY521-entfernt.JPG

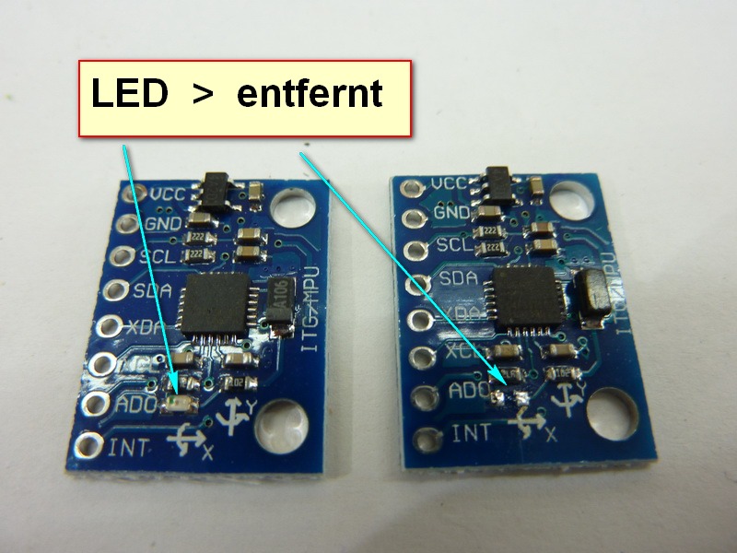
pics/PCB/12-LED-beim-GY521-entfernt.JPG
