knockimov/knocker_brewery_ispindle/pics/PCB/13-GYVerschraubung.JPG

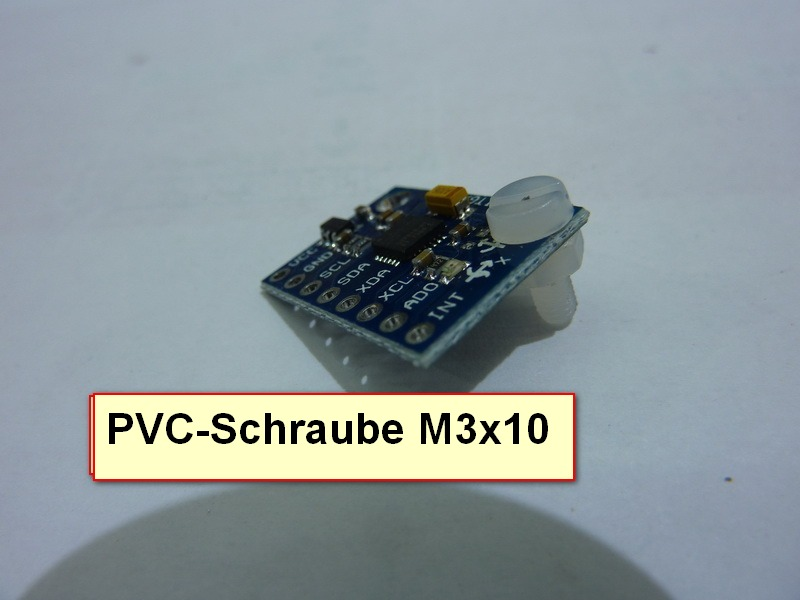
pics/PCB/13-GYVerschraubung.JPG
