knockimov/knocker_brewery_ispindle/pics/PCB/14-GYPinleiste.JPG

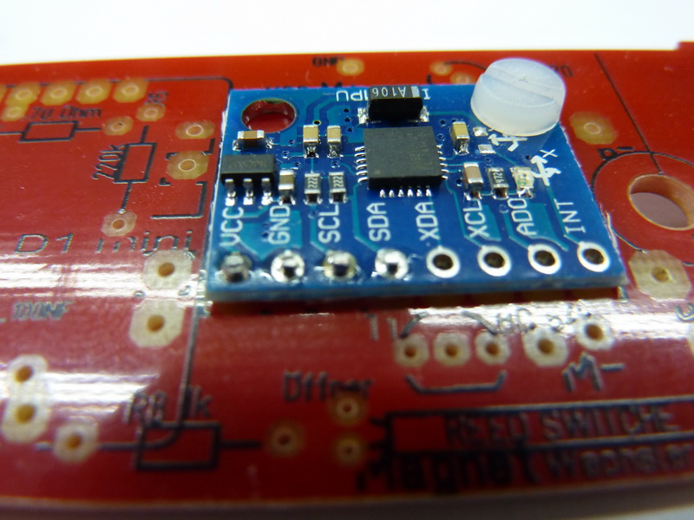
pics/PCB/14-GYPinleiste.JPG
