knockimov/knocker_brewery_ispindle/pics/PCB/15-WemosVorbereitung.JPG

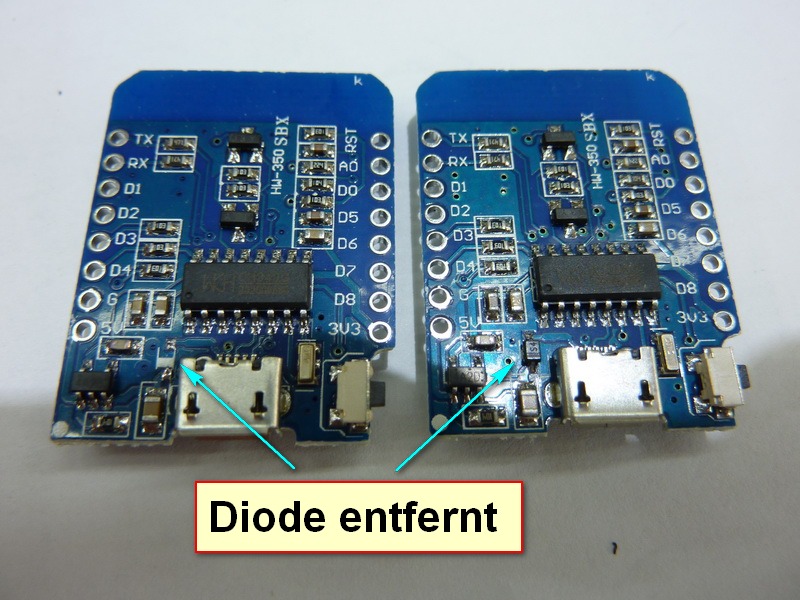
pics/PCB/15-WemosVorbereitung.JPG
