knockimov/knocker_brewery_ispindle/pics/PCB/16-Wemos-USB-Litze.JPG

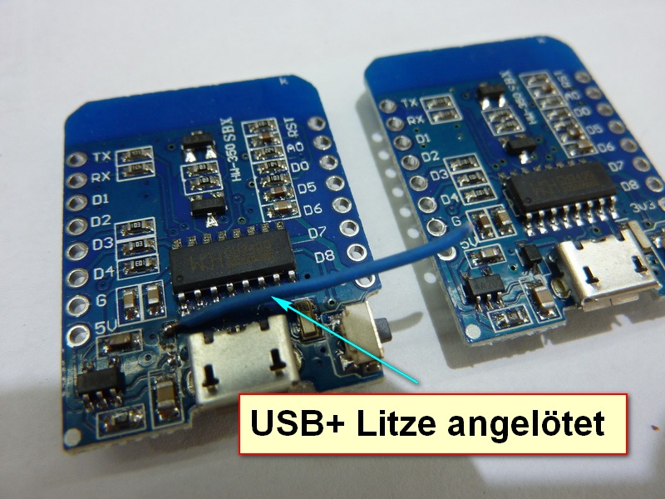
pics/PCB/16-Wemos-USB-Litze.JPG
