knockimov/knocker_brewery_ispindle/pics/PCB/17-Jumper.JPG

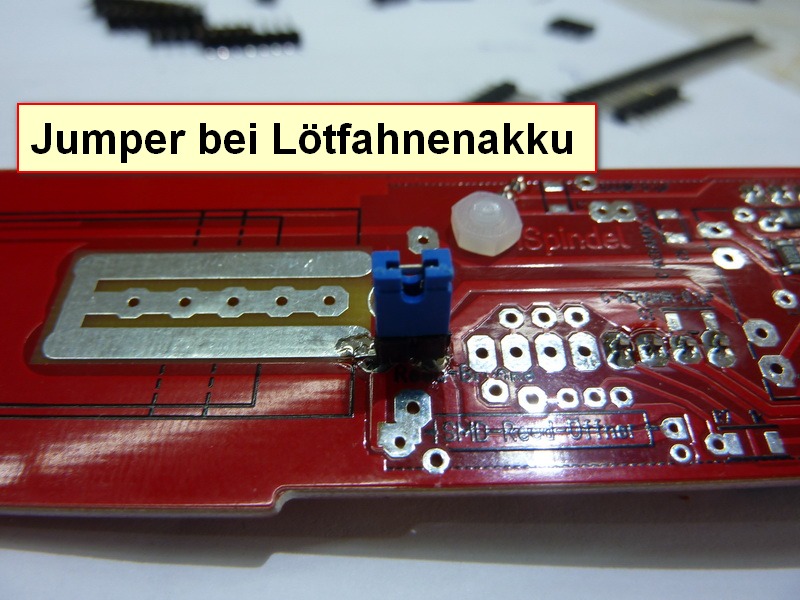
pics/PCB/17-Jumper.JPG
