knockimov/knocker_brewery_ispindle/pics/PCB/18-Loetbild-nurnoetigePinsloeten.JPG

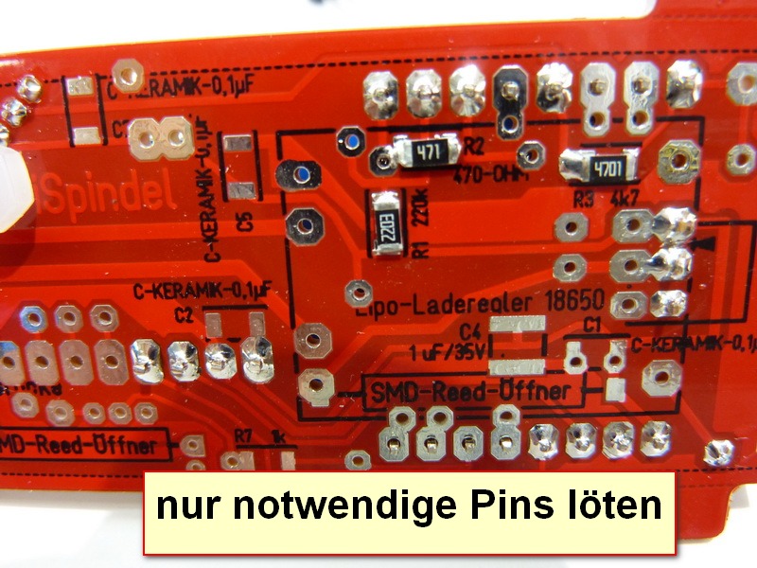
pics/PCB/18-Loetbild-nurnoetigePinsloeten.JPG
