knockimov/knocker_brewery_ispindle/pics/PCB/19-Akkuposition.JPG

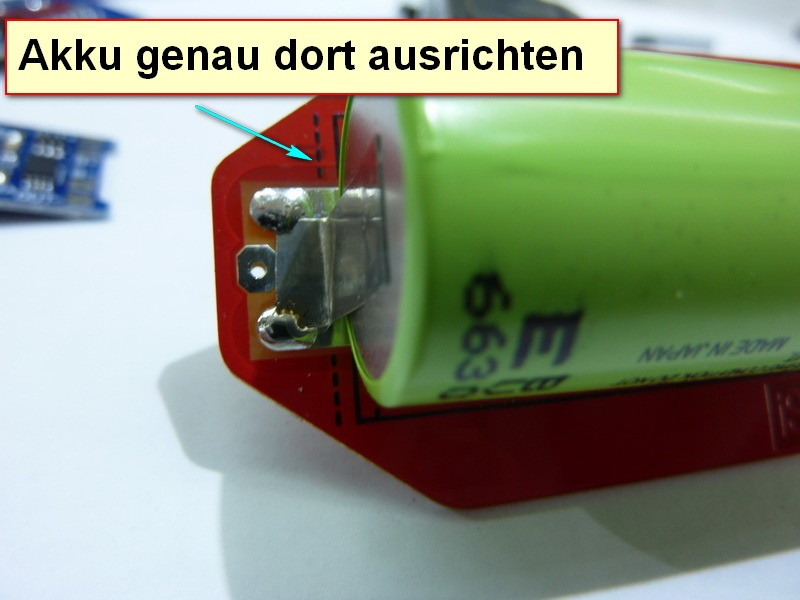
pics/PCB/19-Akkuposition.JPG
