knockimov/knocker_brewery_ispindle/pics/PCB/20-Akkuposition.JPG

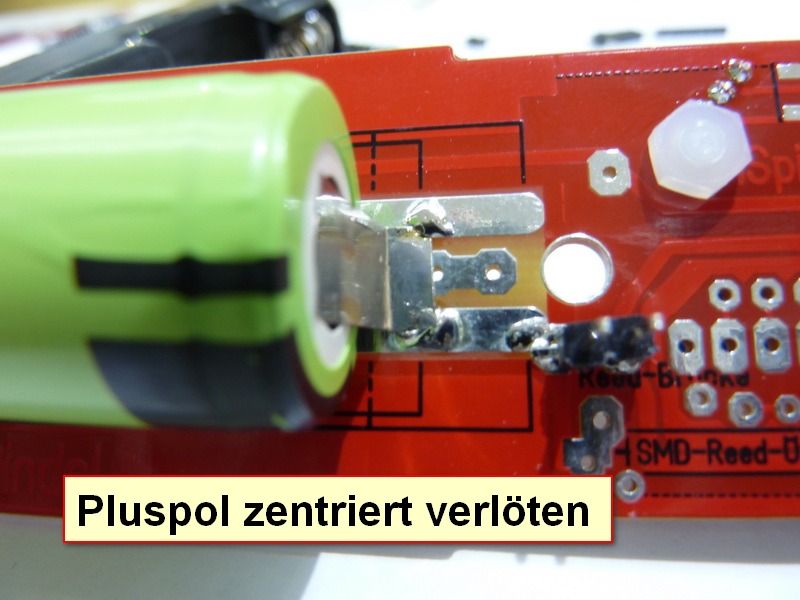
pics/PCB/20-Akkuposition.JPG
