knockimov/knocker_brewery_ispindle/pics/PCB/21-Laderegler.JPG

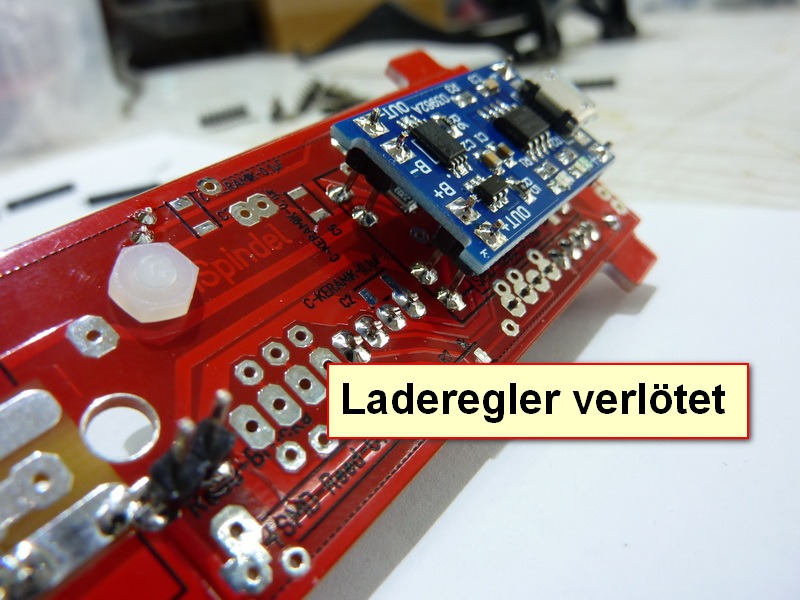
pics/PCB/21-Laderegler.JPG
