knockimov/knocker_brewery_ispindle/pics/PCB/22-Laderegler.JPG

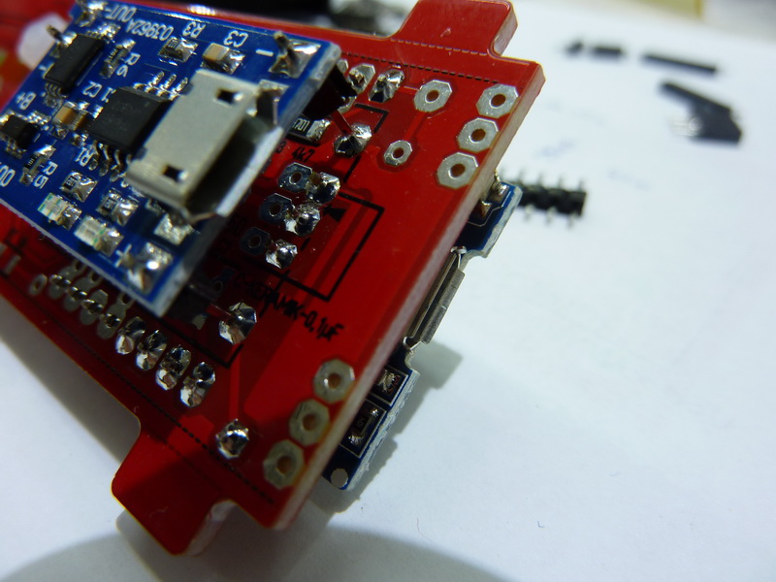
pics/PCB/22-Laderegler.JPG
