knockimov/knocker_brewery_ispindle/pics/PCB/23-Zentrierschraube.JPG

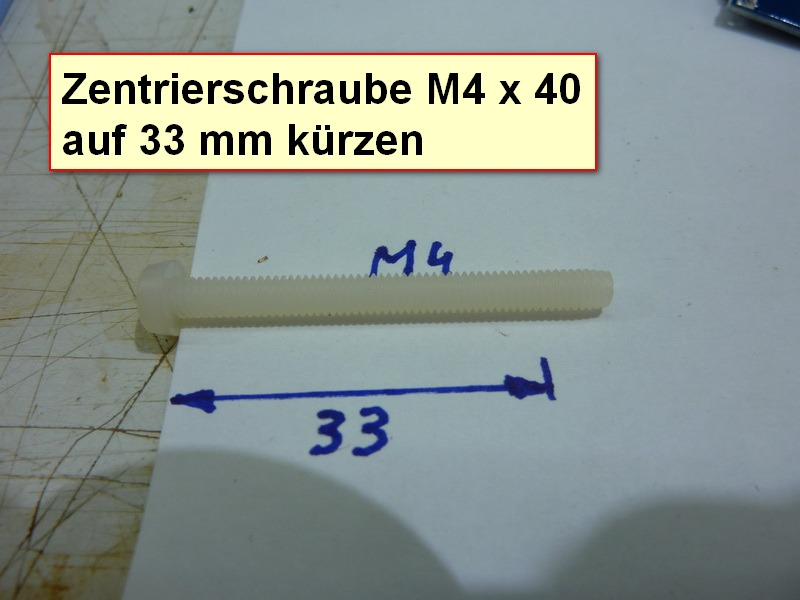
pics/PCB/23-Zentrierschraube.JPG
