knockimov/knocker_brewery_ispindle/pics/PCB/24-Zentrierschraube.JPG

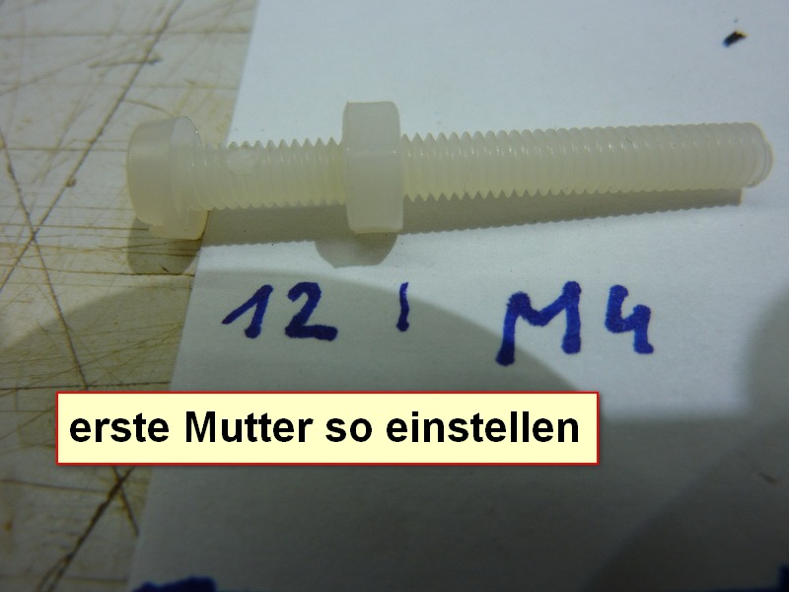
pics/PCB/24-Zentrierschraube.JPG
