knockimov/knocker_brewery_ispindle/pics/PCB/25-Pinkuerzung.JPG

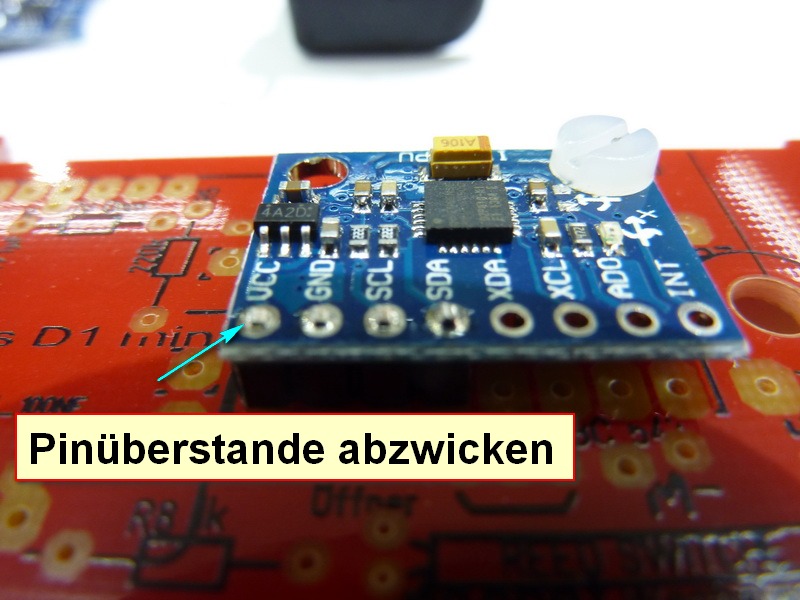
pics/PCB/25-Pinkuerzung.JPG
