knockimov/knocker_brewery_ispindle/pics/PCB/26-Pinkuerzung.JPG

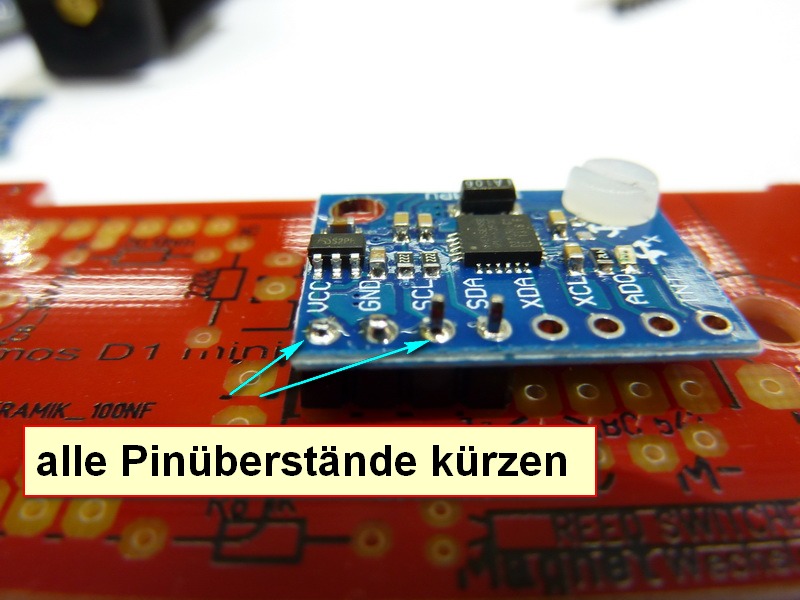
pics/PCB/26-Pinkuerzung.JPG
