knockimov/knocker_brewery_ispindle/pics/PCB/27-Kunststoff-BearbeitungamMinuspoldesAkkuhalters_A_Bildgroesseaendern.jpg

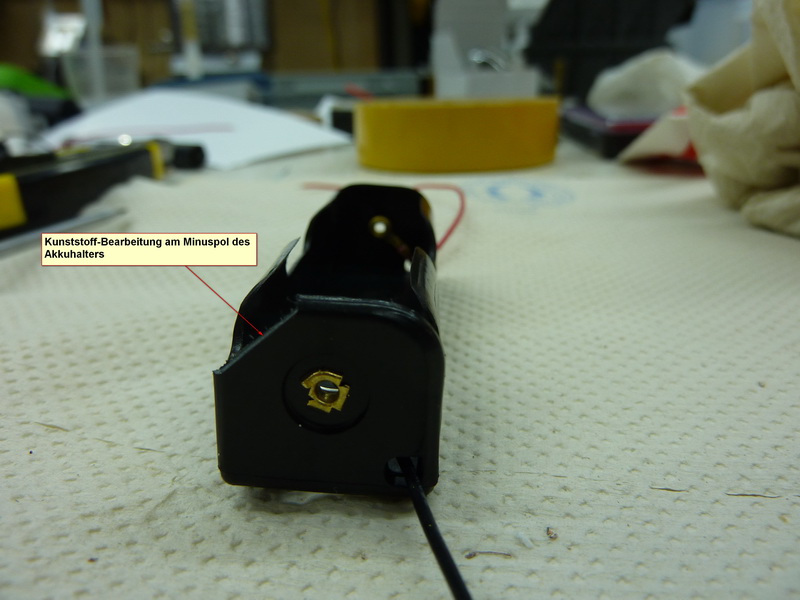
pics/PCB/27-Kunststoff-BearbeitungamMinuspoldesAkkuhalters_A_Bildgroesseaendern.jpg
