knockimov/knocker_brewery_ispindle/pics/PCB/28-Kunststoff-BearbeitungamMinuspoldesAkkuhalters_B_Bildgroesseaendern.jpg

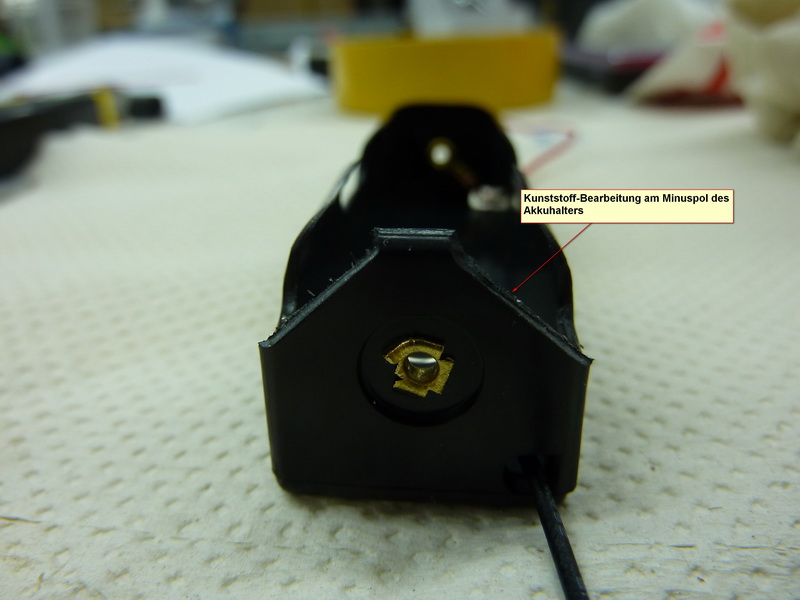
pics/PCB/28-Kunststoff-BearbeitungamMinuspoldesAkkuhalters_B_Bildgroesseaendern.jpg
