knockimov/knocker_brewery_ispindle/pics/PCB/29-Kunststoff-BearbeitungamMinuspoldesAkkuhalters_C_Bildgroesseaendern.jpg

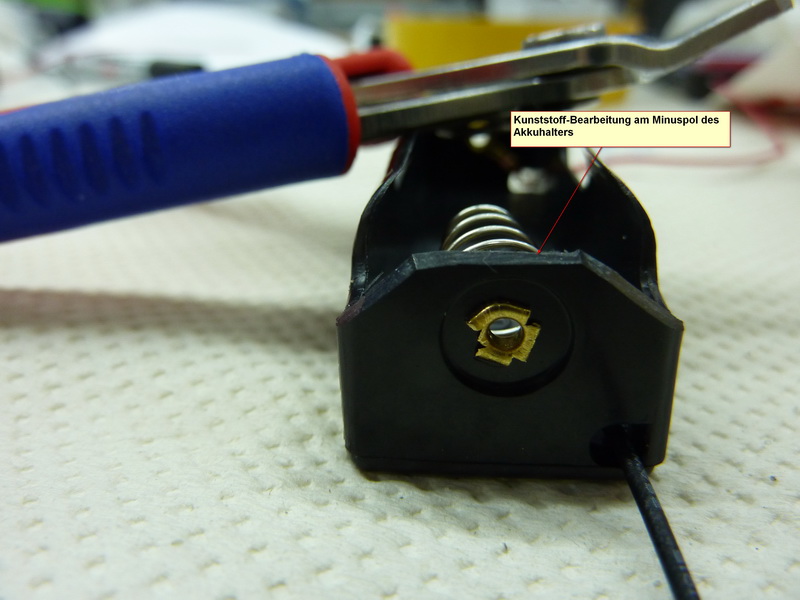
pics/PCB/29-Kunststoff-BearbeitungamMinuspoldesAkkuhalters_C_Bildgroesseaendern.jpg
