knockimov/knocker_brewery_ispindle/pics/PCB/30-Akkuhalterposition.JPG

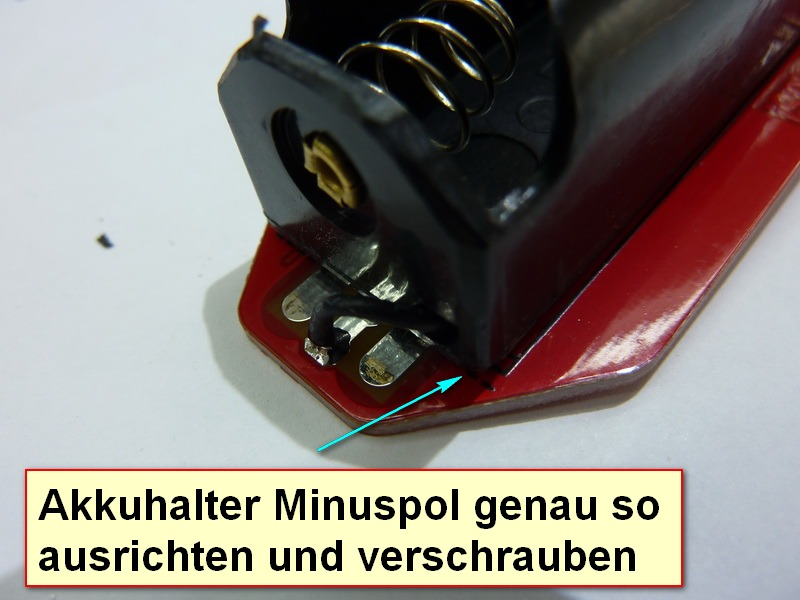
pics/PCB/30-Akkuhalterposition.JPG
