knockimov/knocker_brewery_ispindle/pics/PCB/31-Halterverschraubung.JPG

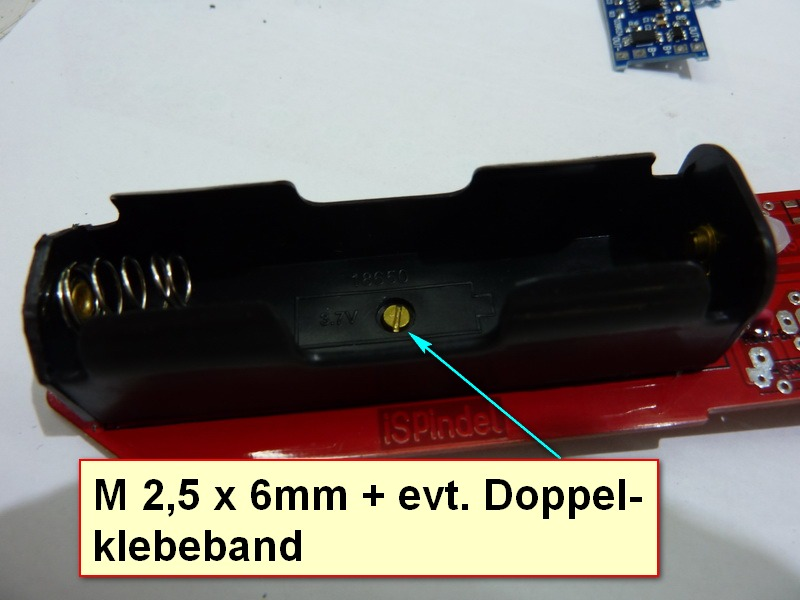
pics/PCB/31-Halterverschraubung.JPG
