knockimov/knocker_brewery_ispindle/pics/PCB/32-Pluspol.JPG

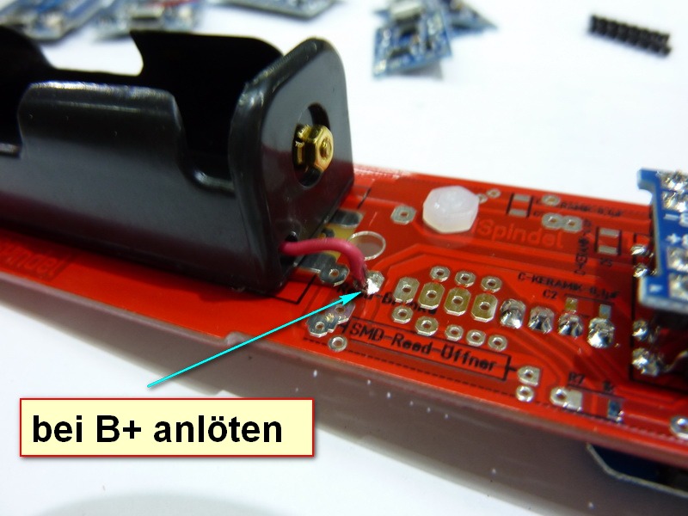
pics/PCB/32-Pluspol.JPG
