knockimov/knocker_brewery_ispindle/pics/PCB/33-VarianteSMD-Reed.JPG

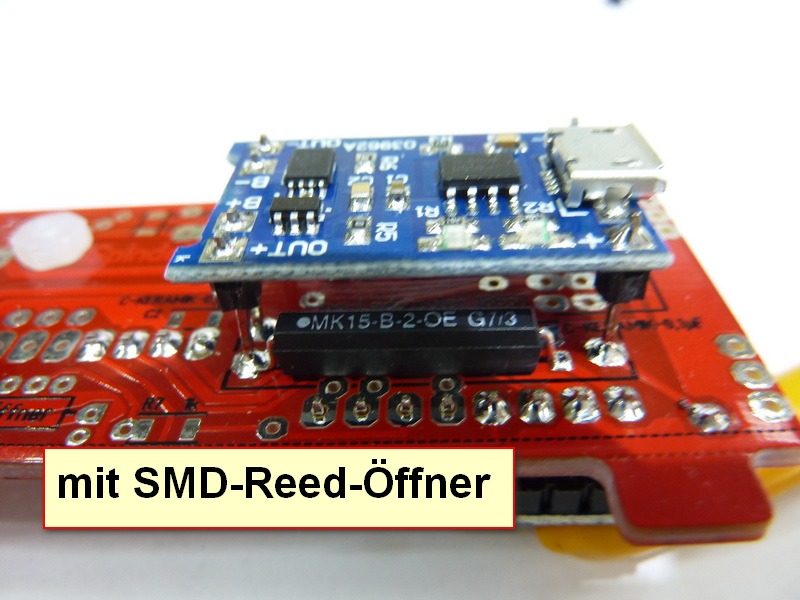
pics/PCB/33-VarianteSMD-Reed.JPG
