knockimov/knocker_brewery_ispindle/pics/PCB/42-MagnetA25mm.JPG

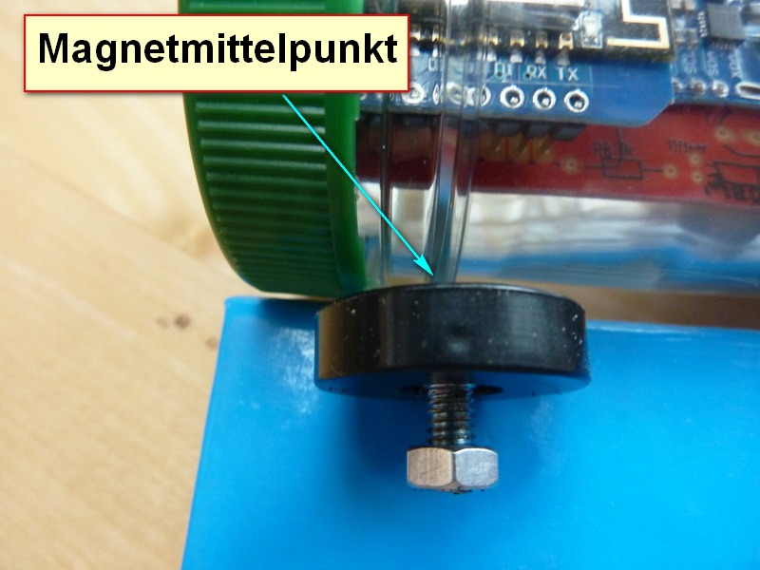
pics/PCB/42-MagnetA25mm.JPG
