knockimov/knocker_brewery_ispindle/pics/PCB/43-MasgnetAmittigPlatine.JPG

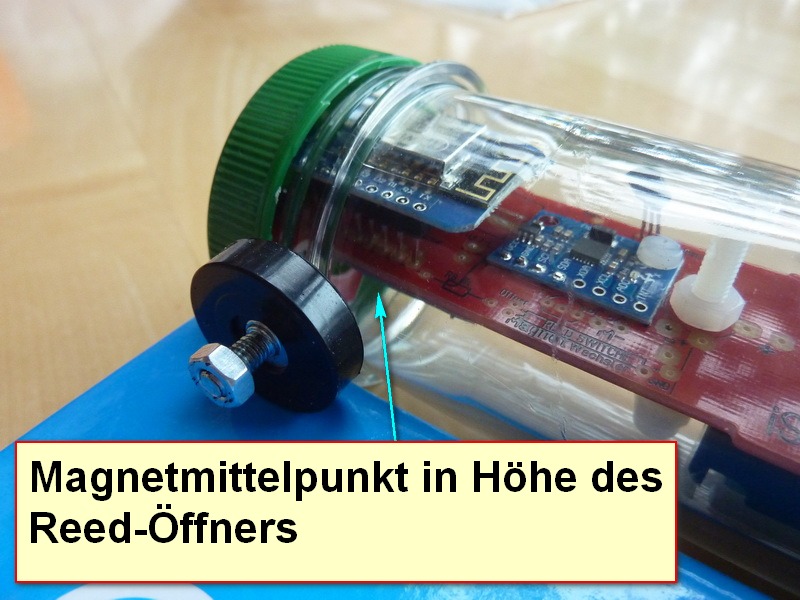
pics/PCB/43-MasgnetAmittigPlatine.JPG
