knockimov/knocker_brewery_ispindle/pics/PCB/44-MagnetB16x11x35.JPG

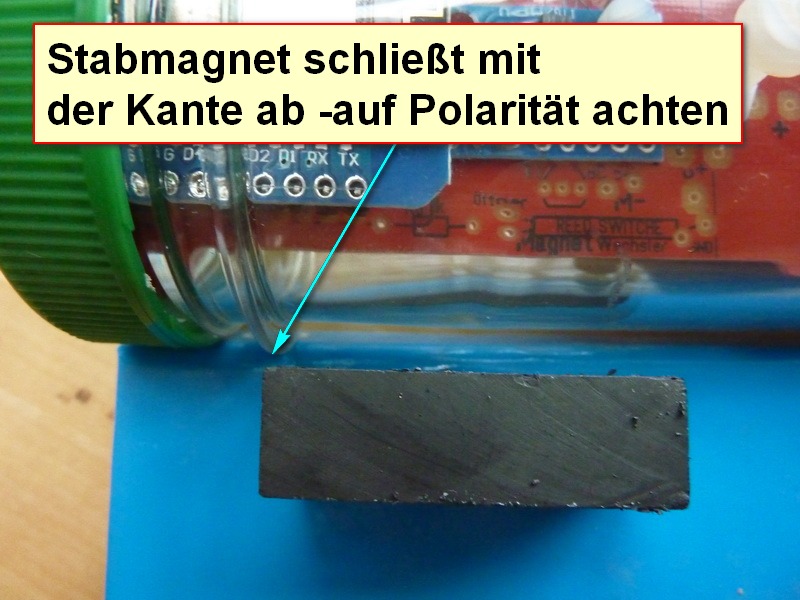
pics/PCB/44-MagnetB16x11x35.JPG
