knockimov/knocker_brewery_ispindle/pics/PCB/45-MagnetBmittigReed.JPG

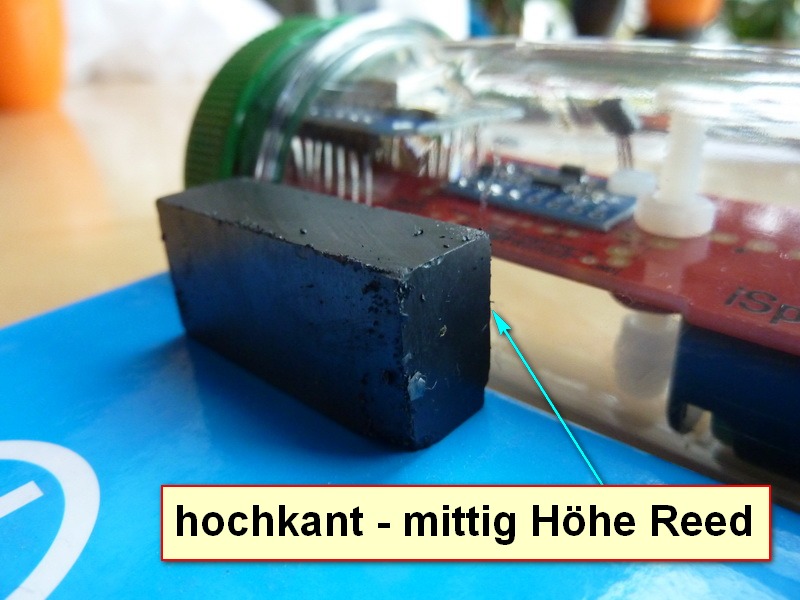
pics/PCB/45-MagnetBmittigReed.JPG
