knockimov/knocker_brewery_ispindle/pics/PCB/46-MagnetC30x7.JPG

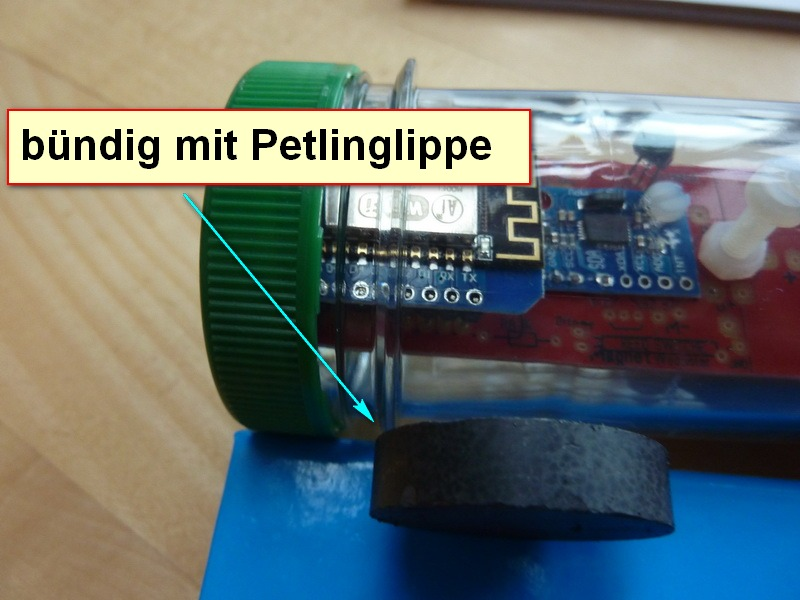
pics/PCB/46-MagnetC30x7.JPG
