knockimov/knocker_brewery_ispindle/pics/Portal.png

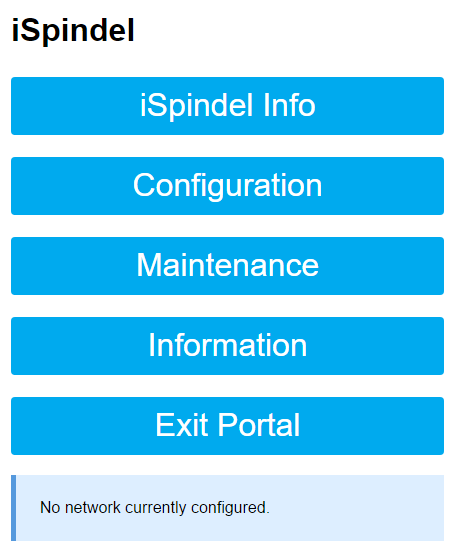
pics/Portal.png
