knockimov/knocker_brewery_ispindle/pics/schematic-en.png

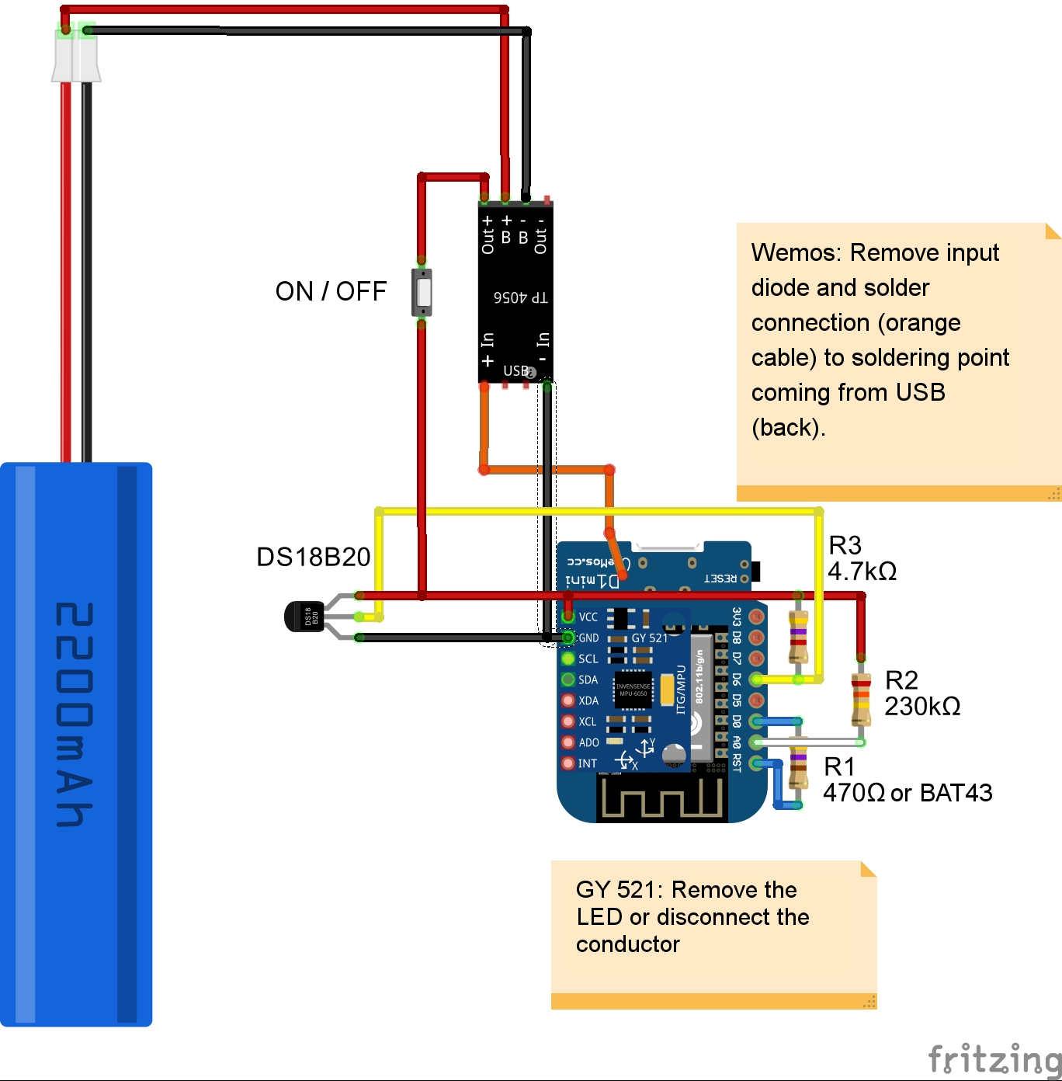
pics/schematic-en.png
