knockimov/knocker_brewery_ispindle/pics/Schlitten_cad.jpg

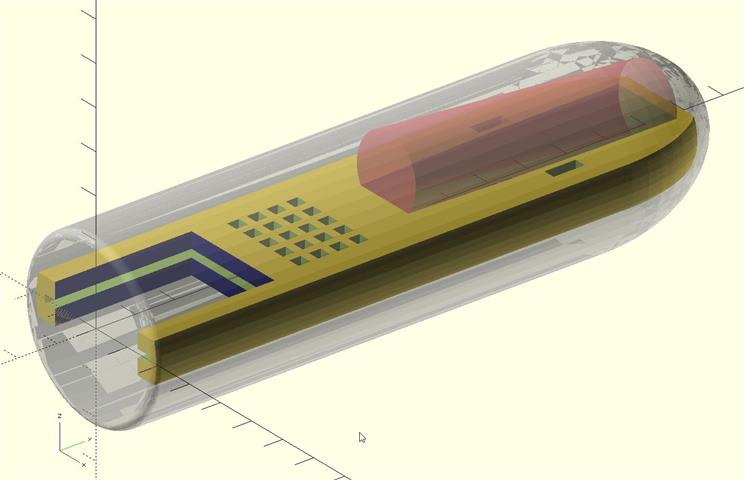
pics/Schlitten_cad.jpg
