knockimov/knocker_brewery_ispindle/pics/Ubiderived.jpg

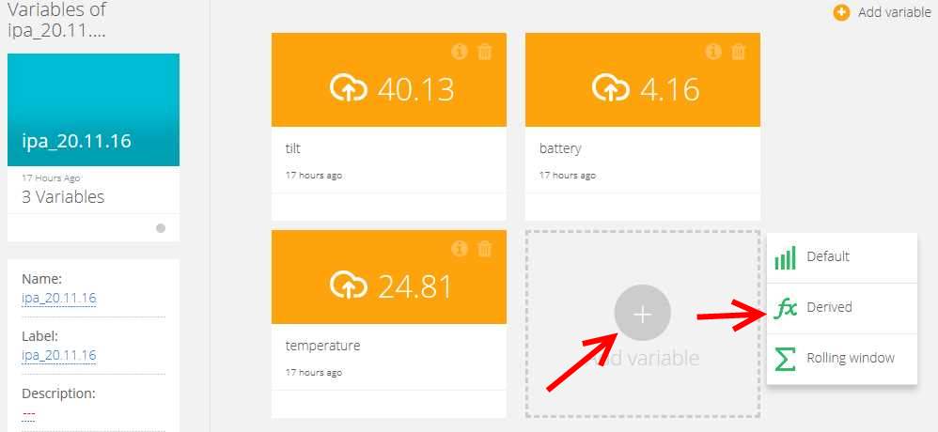
pics/Ubiderived.jpg
