knockimov/knocker_brewery_ispindle/pics/UbiDS.jpg

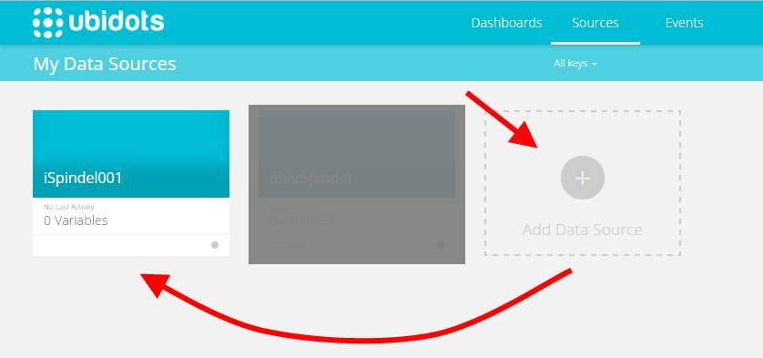
pics/UbiDS.jpg
