knockimov/knocker_brewery_ispindle/pics/UbiIDs.jpg

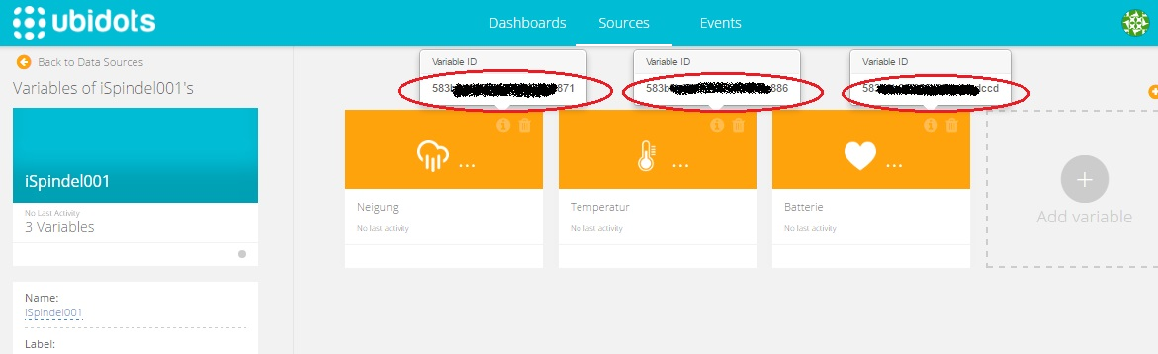
pics/UbiIDs.jpg
