knockimov/knocker_brewery_ispindle/pics/Ubiplato.jpg

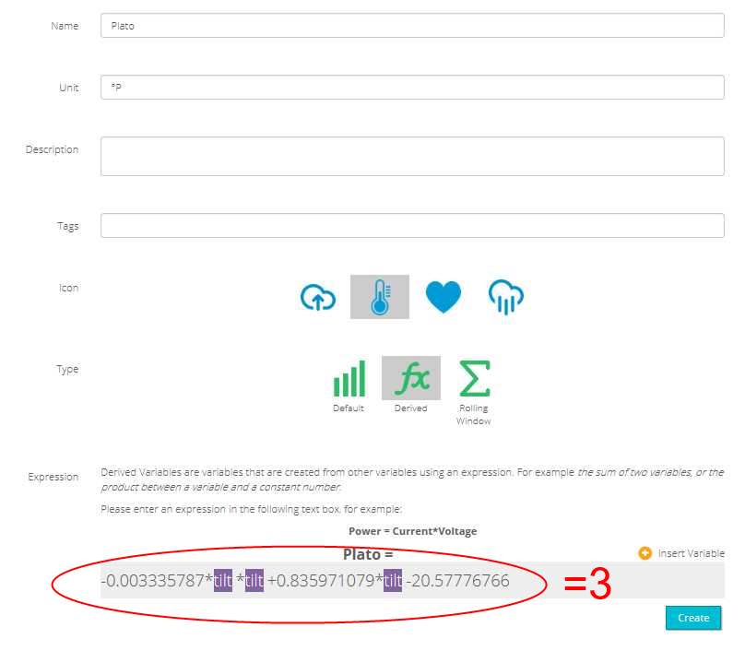
pics/Ubiplato.jpg
