knockimov/knocker_brewery_ispindle/drawer/drawer-36x133-thing2231986.stl

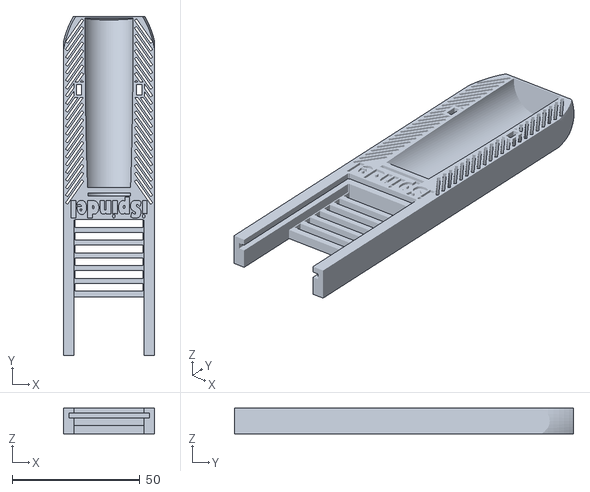
[picture p107: CAD file, 2018-04-15]
drawer/drawer-36x133-thing2231986.stl
35.5 x 132.7 x 10.0
