knockimov/knocker_brewery_ispindle/drawer/mwx-Edition/iSpindelBackbone2.stl

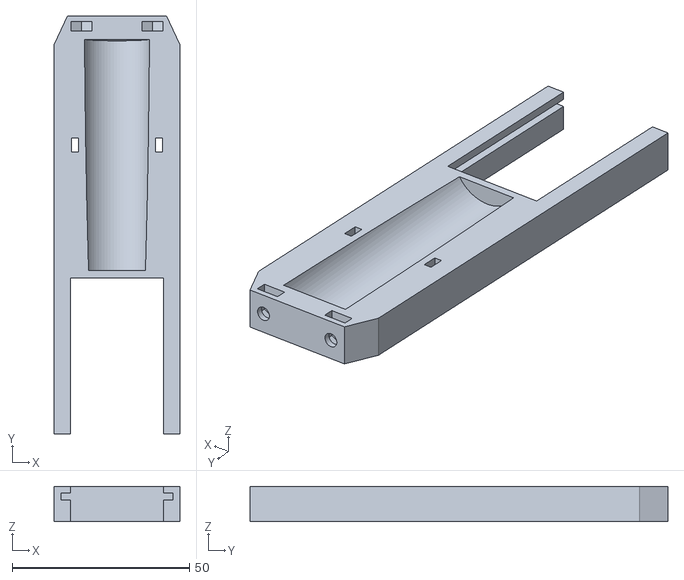
[picture p108: CAD file, 2018-04-15]
drawer/mwx-Edition/iSpindelBackbone2.stl
35.6 x 118.0 x 10.0
