knockimov/knocker_brewery_ispindle/drawer/drawer-38x145-Geocaching.stl

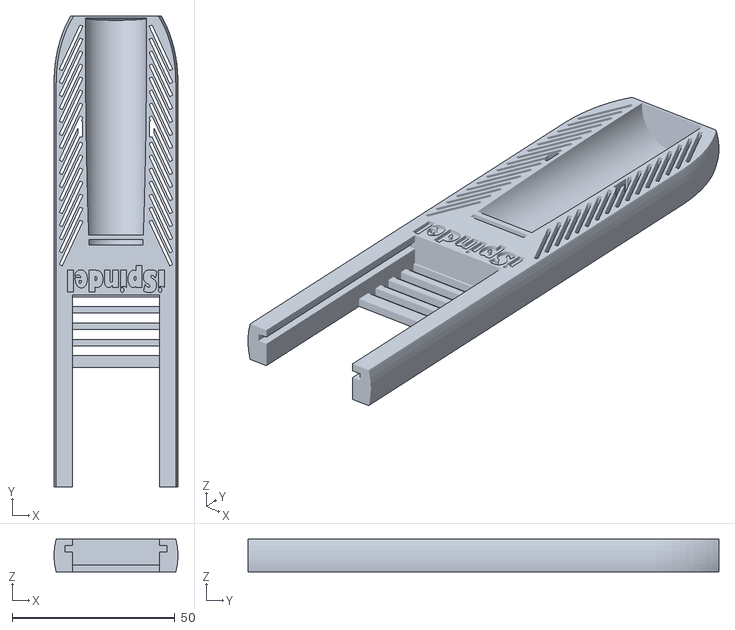
[picture p109: CAD file, 2018-04-15]
drawer/drawer-38x145-Geocaching.stl
38.1 x 144.7 x 10.0
