knockimov/knocker_brewery_ispindle/drawer/drawer-38x139.stl

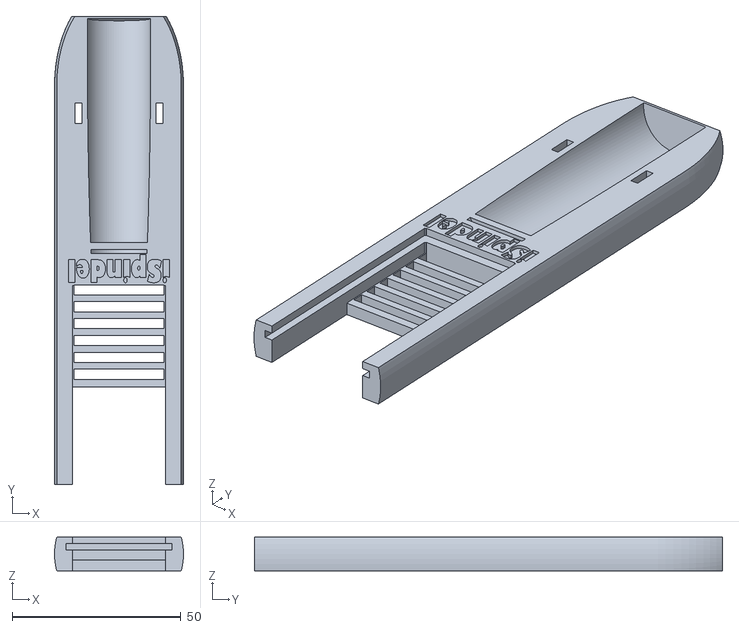
[picture p110: CAD file, 2018-04-15]
drawer/drawer-38x139.stl
38.2 x 138.7 x 10.0
