knockimov/knocker_brewery_ispindle/drawer/drawer-38x150-Geocaching.stl

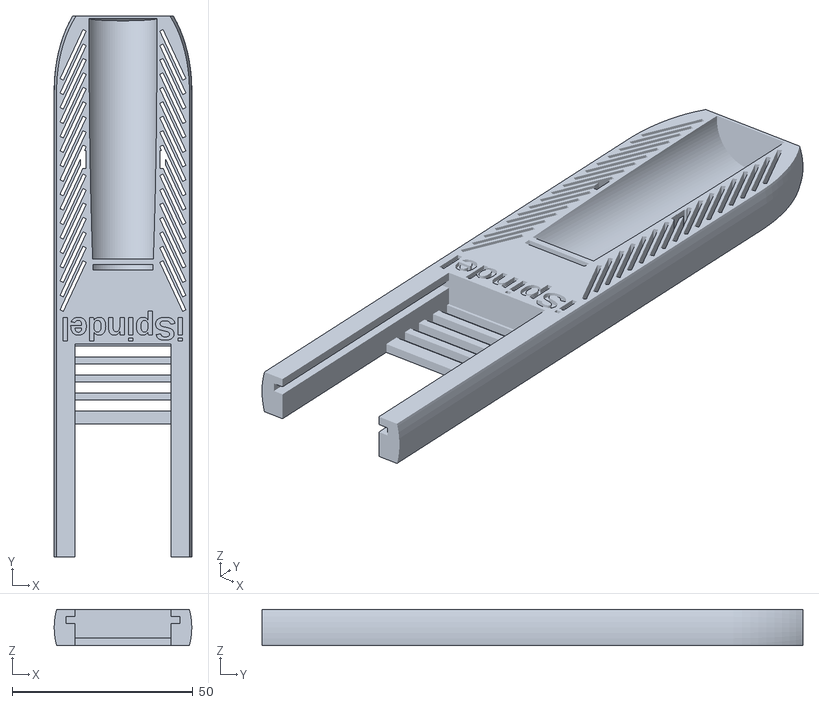
[picture p111: CAD file, 2018-04-15]
drawer/drawer-38x150-Geocaching.stl
38.1 x 149.7 x 10.0
