knockimov/knocker_brewery_ispindle/drawer/drawer-38x133.stl

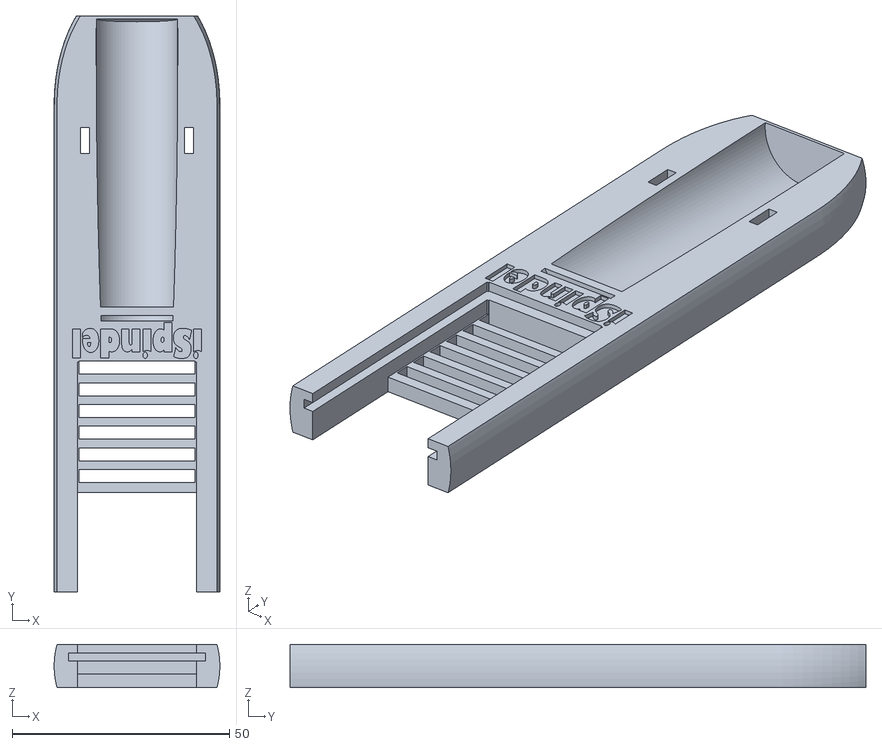
[picture p112: CAD file, 2018-04-15]
drawer/drawer-38x133.stl
38.2 x 132.7 x 10.0
