knockimov/knocker_brewery_ispindle/drawer/drawer-combo-short-spring.stl

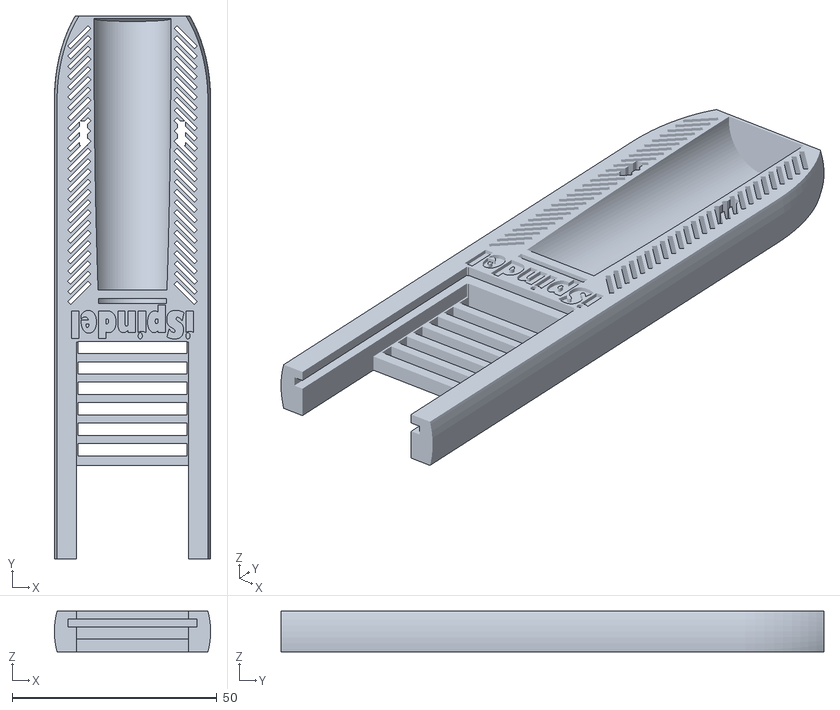
[picture p113: CAD file, 2018-04-15]
drawer/drawer-combo-short-spring.stl
38.2 x 132.7 x 10.0
