knockimov/knocker_brewery_ispindle/drawer/iSpindel mechatronics.stl

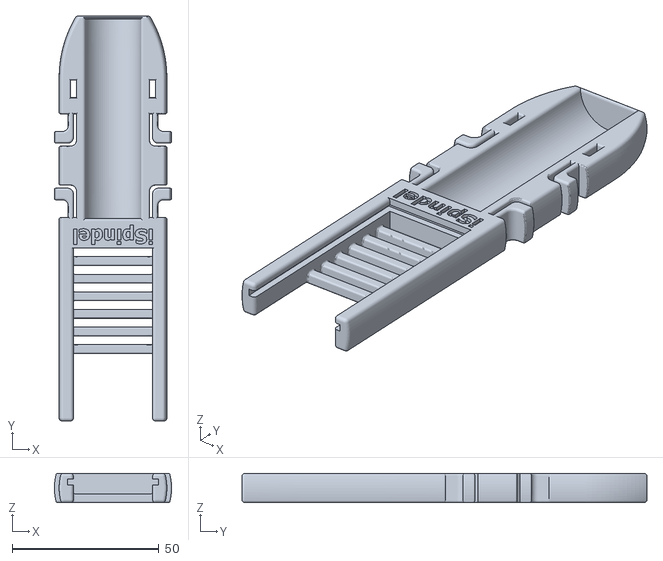
[picture p114: CAD file, 2018-04-15]
drawer/iSpindel mechatronics.stl
39.9 x 138.0 x 10.0
