knockimov/knocker_brewery_ispindle/drawer/drawer-combo-short-spring2.stl

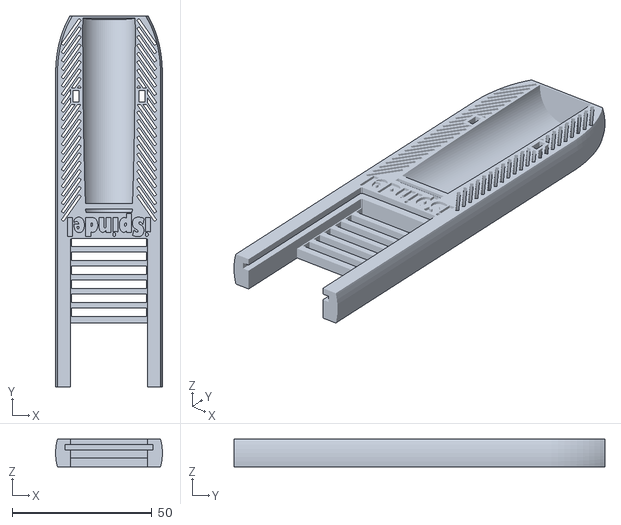
[picture p115: CAD file, 2018-04-15]
drawer/drawer-combo-short-spring2.stl
38.2 x 132.7 x 10.0
