knockimov/knocker_brewery_ispindle/(list of files, cad)

Other CAD files:
drawer/mwx-Edition/iSpindelBackbone2.scad
drawer/mwx-Edition/iSpindelThread.scad
drawer/mwx-Edition/U12.scad
