knockimov/knocker_brewery_ispindle/images/iSpindle_solderpattern.png

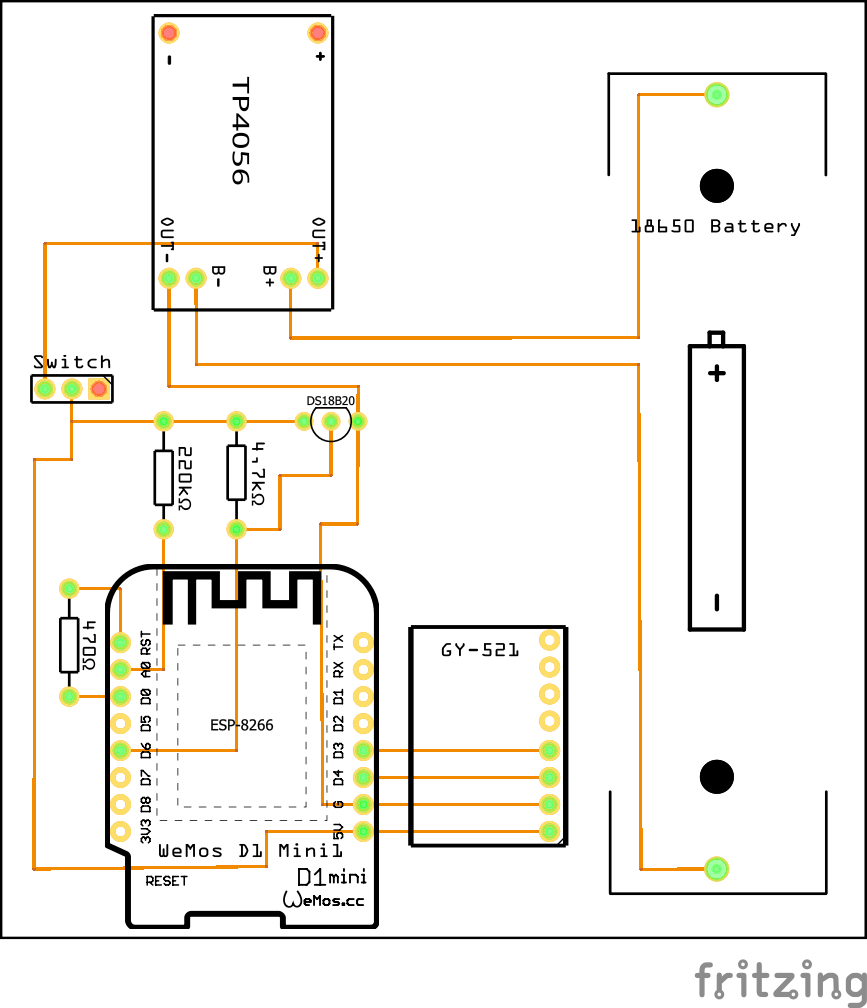
images/iSpindle_solderpattern.png
