knockimov/knocker_brewery_ispindle/docs/Kalibrierung_en.xlsm

Calibration of the iSpindel |  |  |  | Plato Formel: | 0.004461909*tilt^2 - 0.063583024*tilt - 1.252533981
Measured Angle (°) | Measured SG | Measured °Plato | Deviation °
26.67 | 1.0000 | -0.003 | -0.23 °P
35.68 | 1.0090 | 2.306377381 | 0.15 °P
45.82 | 1.0220 | 5.579778092 | 0.38 °P
51.43 | 1.0300 | 7.558229019 | 0.28 °P
59.05 | 1.0410 | 10.23478569 | -0.32 °P
64.44 | 1.0500 | 12.38764713 | -0.79 °P
68.49 | 1.0610 | 14.97456813 | -0.35 °P
71.24 | 1.0730 | 17.7422207 | 0.88 °P
