knockimov/knocker_brewery_ispindle/docs/Kalibrierung.xlsm

Kalibrierung iSpindel
 | gemessener Winkel (°) | gemessener °Plato | Abweichung °
 | 39 | 0 | -0.54 °P
 | 44.4 | 2.8 | 0.82 °P
 | 65.15 | 11.5 | -0.77 °P
 | 70.99 | 17 | 0.49 °P
Plato Formel:
0.008699786*tilt^2 - 0.457563239*tilt + 5.15023517
