knockimov/knocker_brewery_ispindle/pics/Calibration_Sheet_EN.PNG

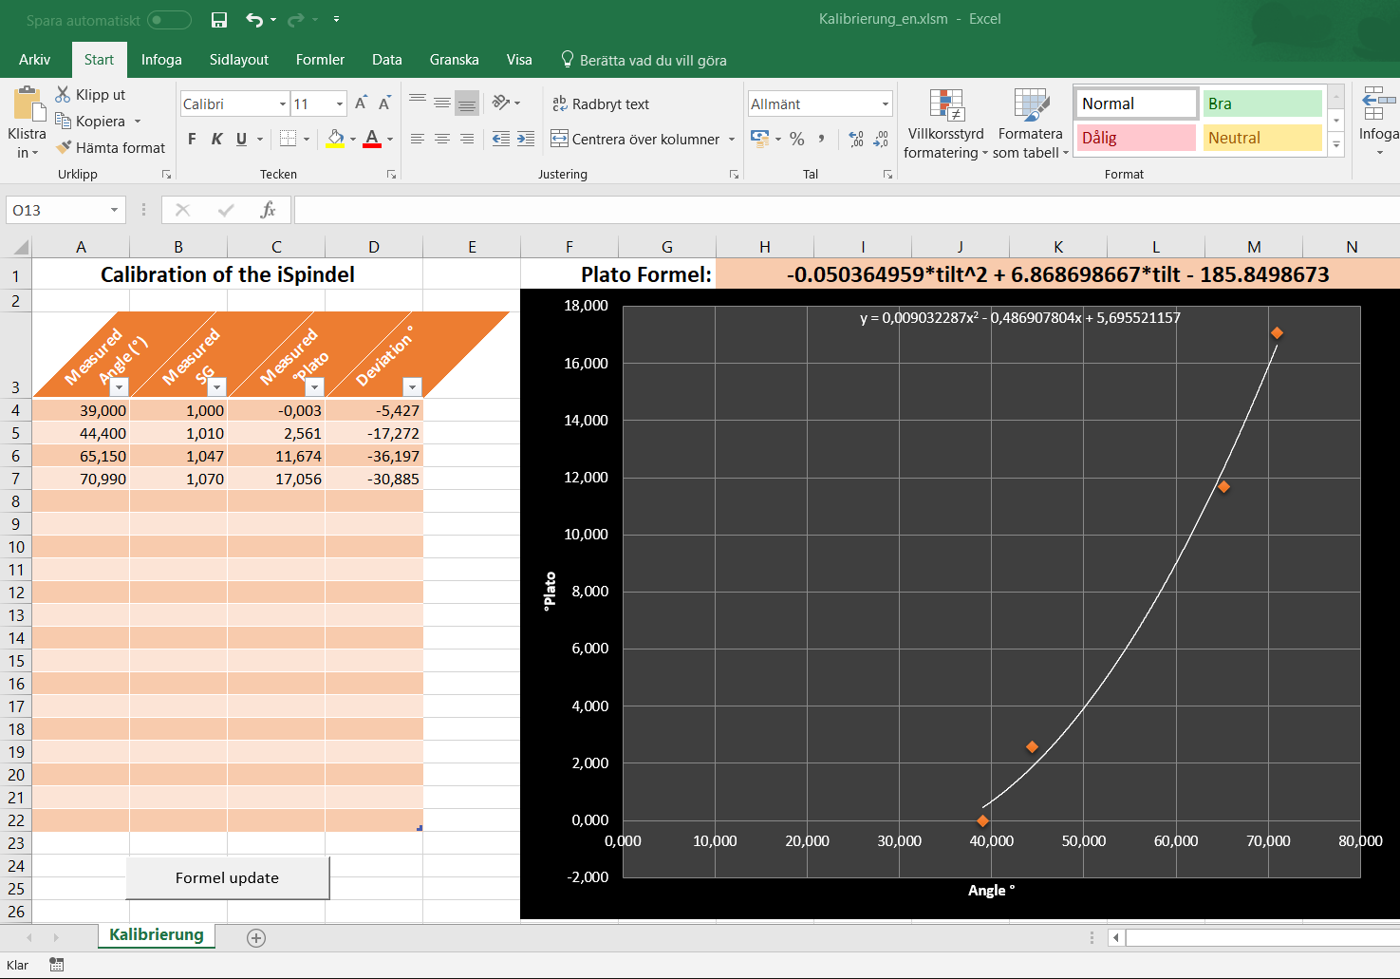
pics/Calibration_Sheet_EN.PNG
