knockimov/knocker_brewery_ispindle/images/ispindel-v150-ESP12F--SMD1206-BreadbordFIX_bb.png

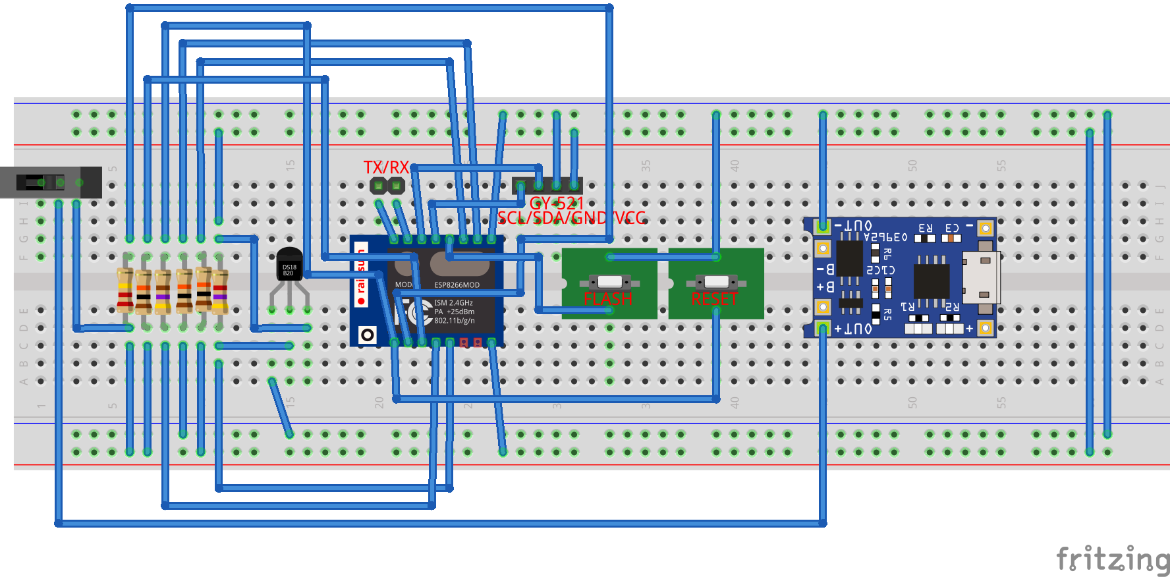
images/ispindel-v150-ESP12F--SMD1206-BreadbordFIX_bb.png
