knockimov/knocker_brewery_ispindle/pics/maintenance.png

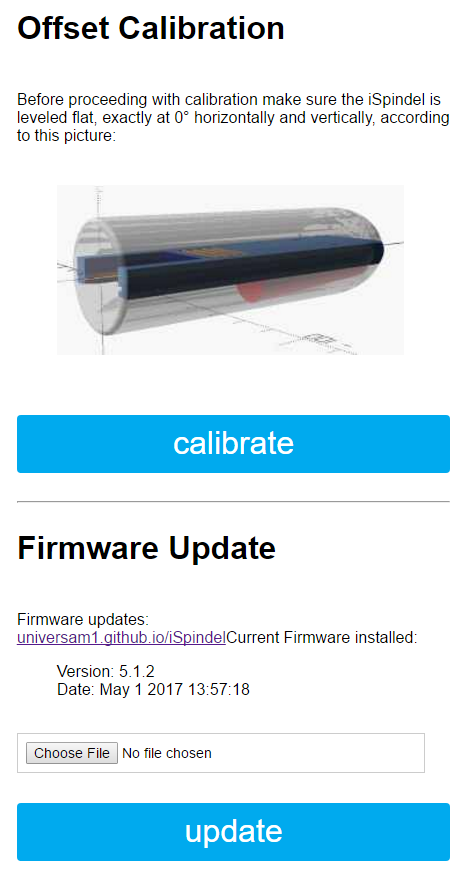
pics/maintenance.png
