knockimov/knocker_brewery_ispindle/(list of files, drawings)

Other design files:
fritzing/ispindel-v150-ESP12F--SMD1206.fzz
fritzing/ispindel-v150-WemosD1--SMD1206.fzz
